ZeniteSolar/MSWI19/design/imgs_iteration_1/sw_1_var_1.jpeg

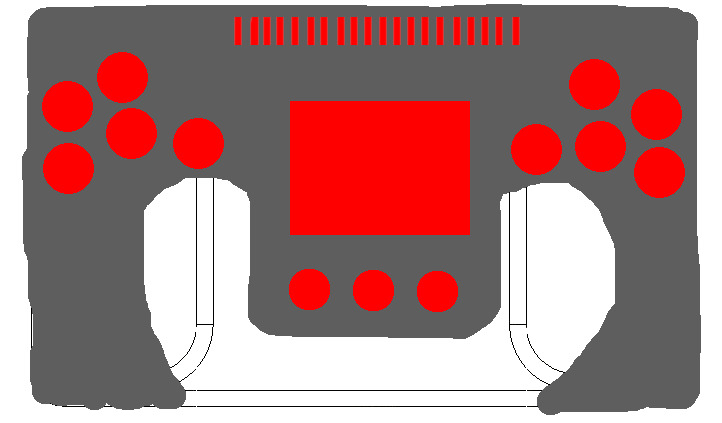
design/imgs_iteration_1/sw_1_var_1.jpeg
