ZeniteSolar/MSWI19/design/imgs_iteration_1/sw_1_var_2.jpeg

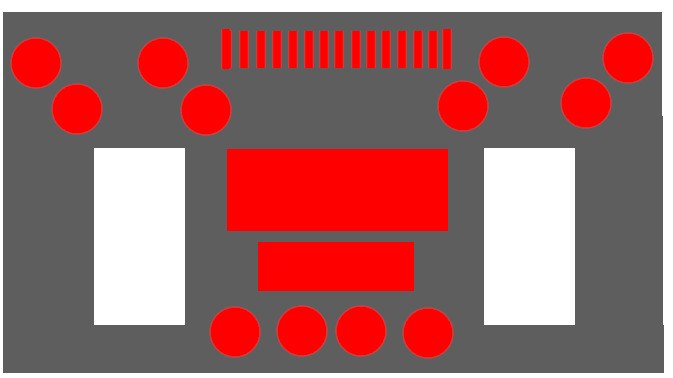
design/imgs_iteration_1/sw_1_var_2.jpeg
