ZeniteSolar/MSWI19/pcb/mswi/IMG/mswi-front.png

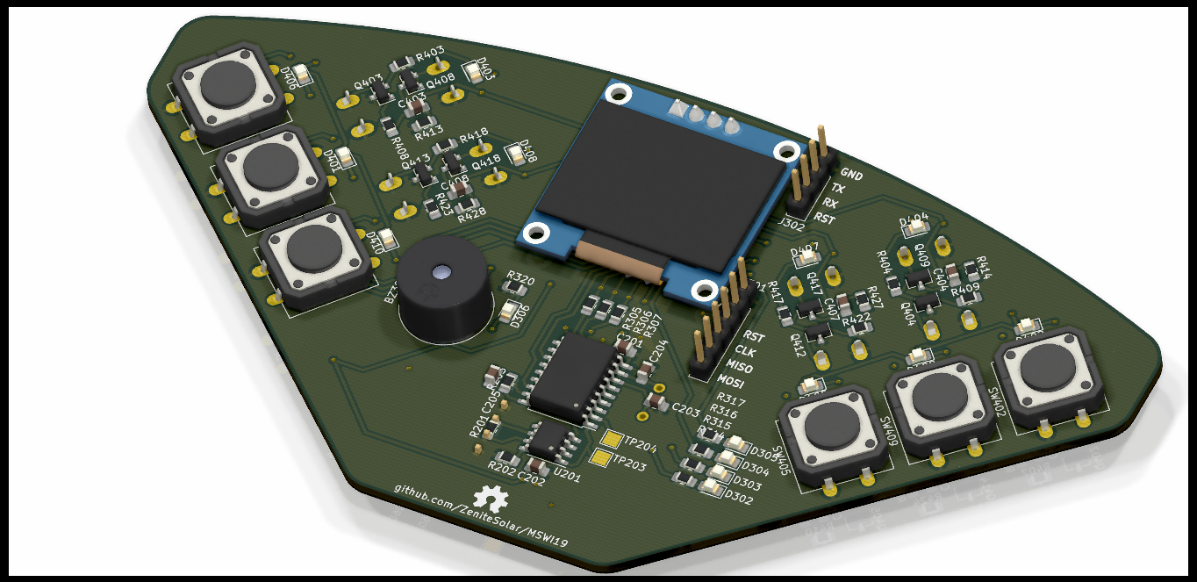
pcb/mswi/IMG/mswi-front.png
