ZeniteSolar/MSWI19/design/3D/costa_tampa.STL

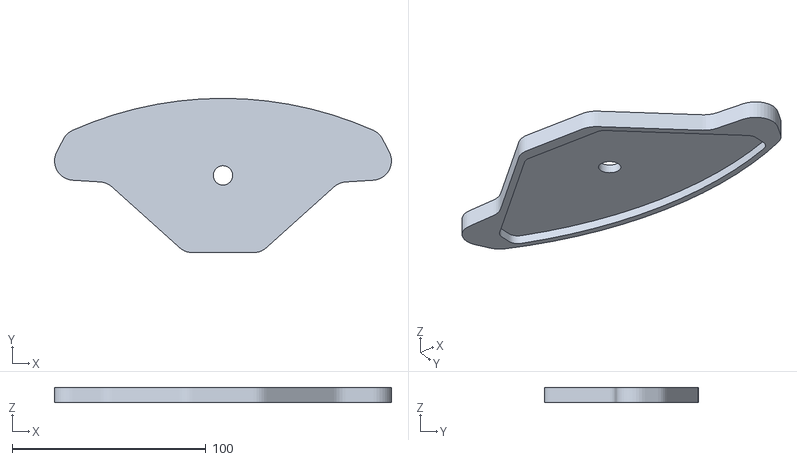
[picture p20: CAD file, 2019-12-08]
design/3D/costa_tampa.STL
174.0 x 79.7 x 8.00
