ZeniteSolar/MSWI19/design/models/display.step

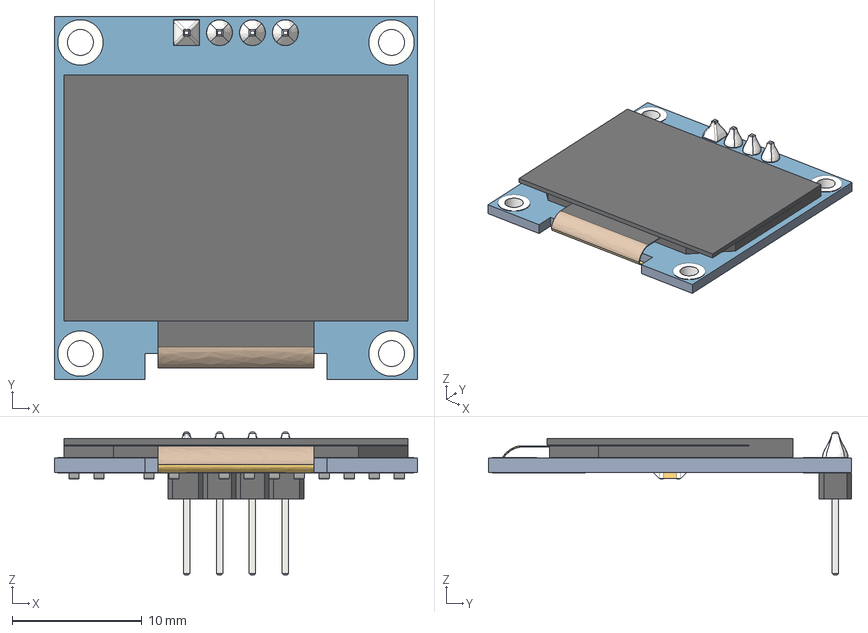
[picture p21: CAD file, 2019-10-22]
design/models/display.step
28.0 x 28.0 x 11.0 mm
