ZeniteSolar/MSWI19/design/placa_joaoa_timao.DXF

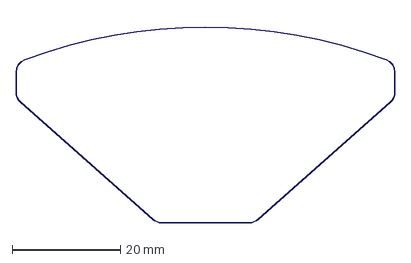
[picture p22: CAD file, 2019-08-30]
design/placa_joaoa_timao.DXF
70.0 x 38.2 mm
