ZeniteSolar/MSWI19/design/3D/CON_TIMAO_BARCO.STL

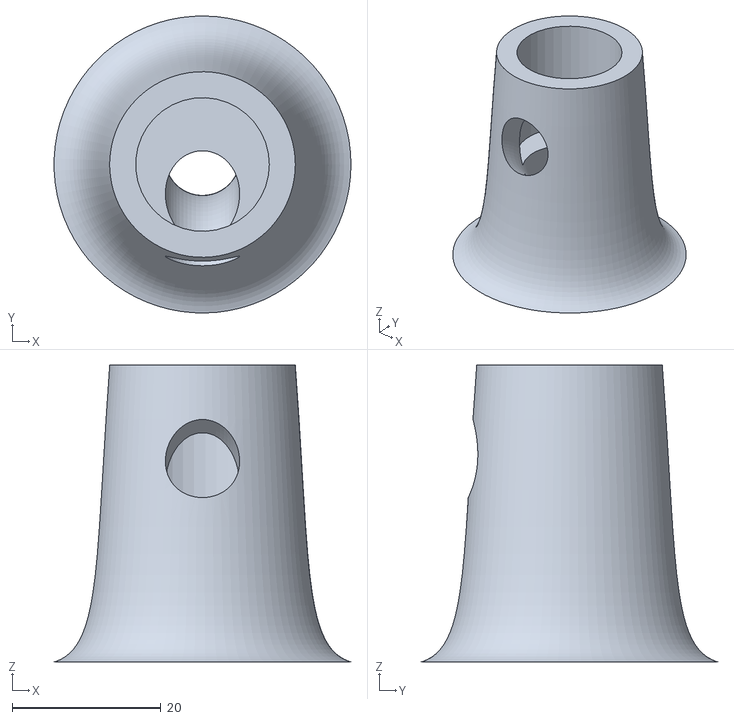
[picture p23: CAD file, 2019-12-08]
design/3D/CON_TIMAO_BARCO.STL
40.0 x 40.0 x 40.0
