ZeniteSolar/MSWI19/design/models/buzzer.step

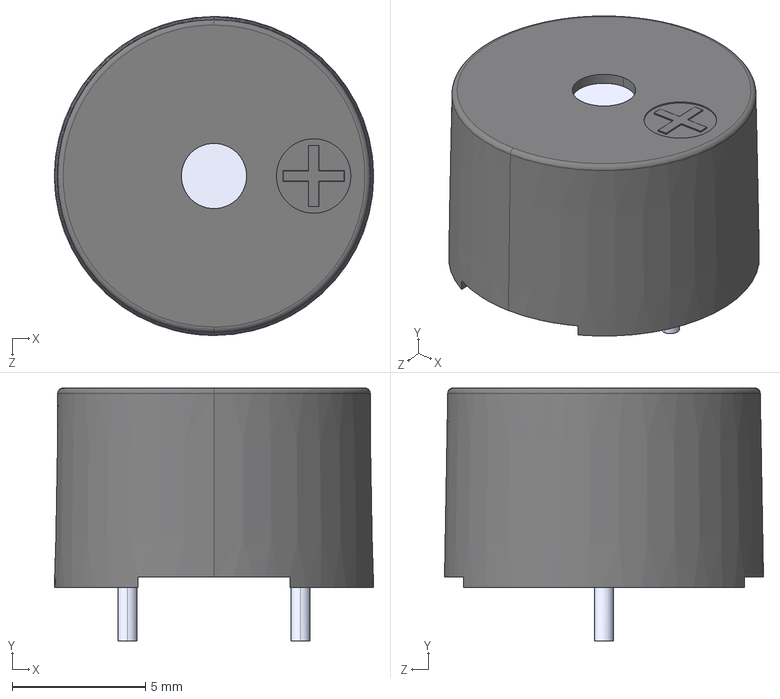
[picture p24: CAD file, 2019-10-16]
design/models/buzzer.step
12.0 x 9.50 x 12.0 mm
