ZeniteSolar/MSWI19/design/timao_joao_2_3.DXF

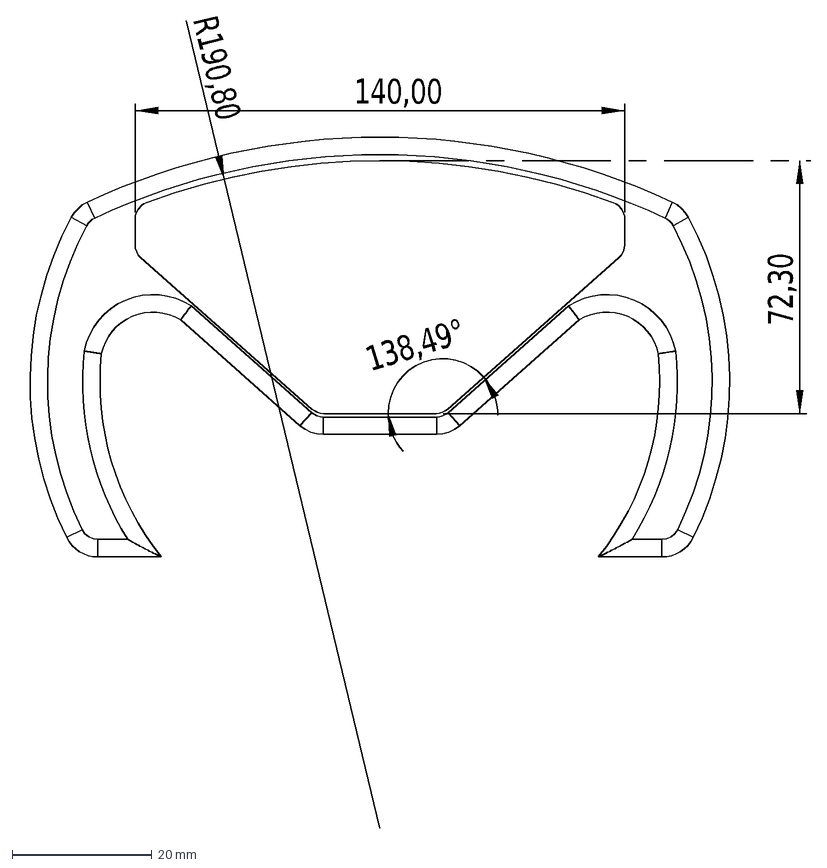
[picture p25: CAD file, 2019-08-30]
design/timao_joao_2_3.DXF
72,30
140,00
R190,80
138,49°
