ZeniteSolar/MSWI19/design/3D/timao_joao_V_2.STL

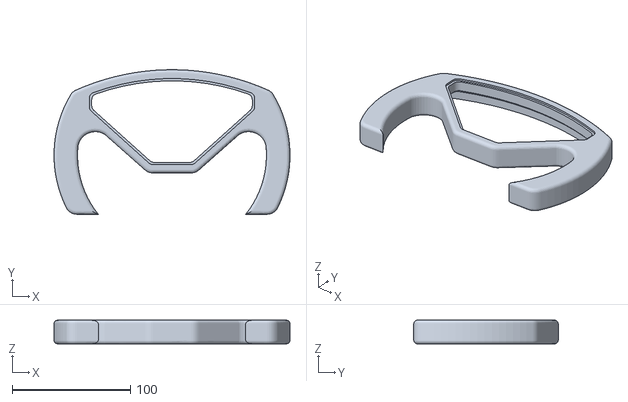
[picture p26: CAD file, 2019-12-08]
design/3D/timao_joao_V_2.STL
199.9 x 122.5 x 20.0
