ZeniteSolar/MSWI19/design/models/switch.FCStd

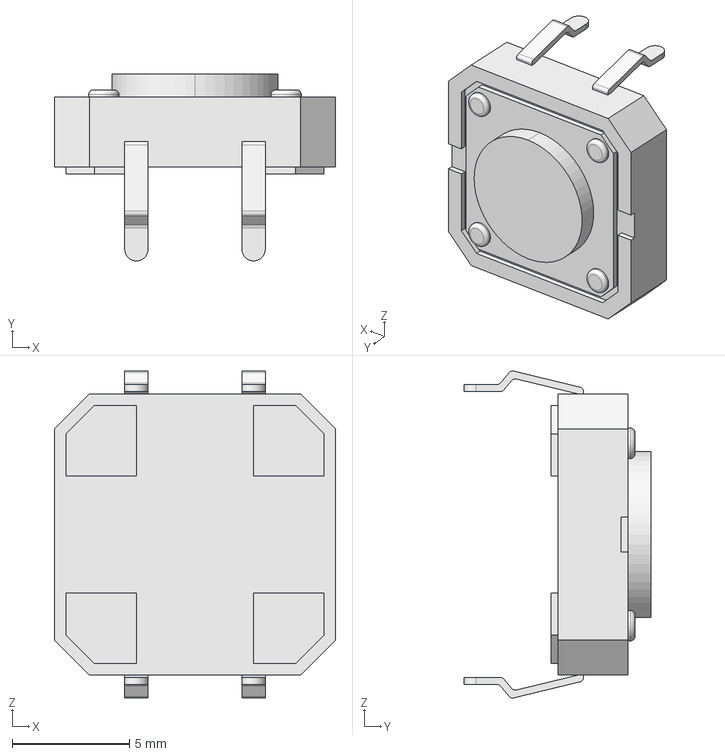
[picture p27: CAD file, 2019-10-16]
design/models/switch.FCStd
12.0 x 7.97 x 14.0 mm
