ZeniteSolar/MSWI19/pcb/mswi/PDF/mswi-Eco2_User.pdf

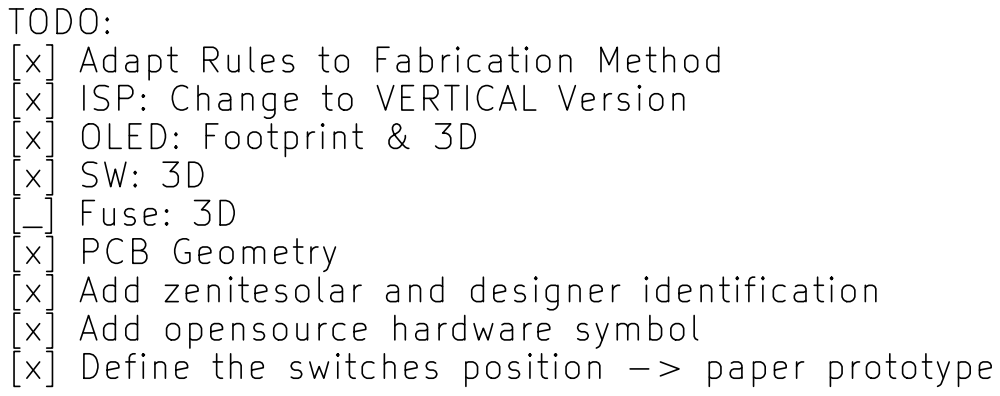
[picture p28: page 1]

TODO:
[x] Adapt Rules to Fabrication Method
[x] ISP: Change to VERTICAL Version
[x] OLED: Footprint & 3D
[_] Fuse: 3D
[x] PCB Geometry
[x] Add zenitesolar and designer identification
[x] Add opensource hardware symbol
[x] Define the switches position -> paper prototype
