ZeniteSolar/MSWI19/pcb/mswi/PDF/mswi.pdf

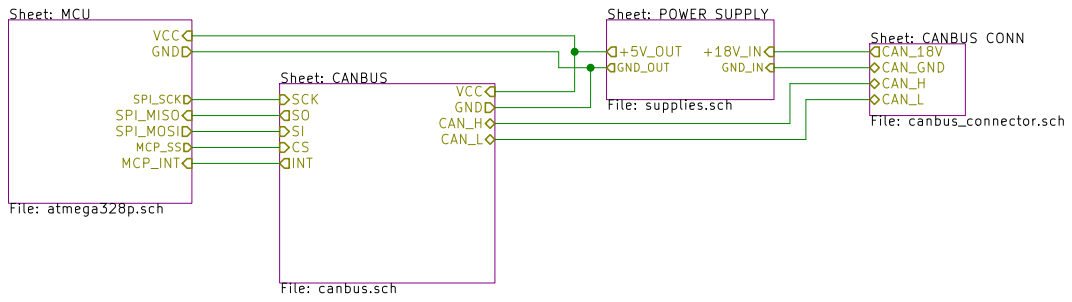
[picture p29: page 1]

Id: 1/6 Title: File: mswi.sch Sheet: /

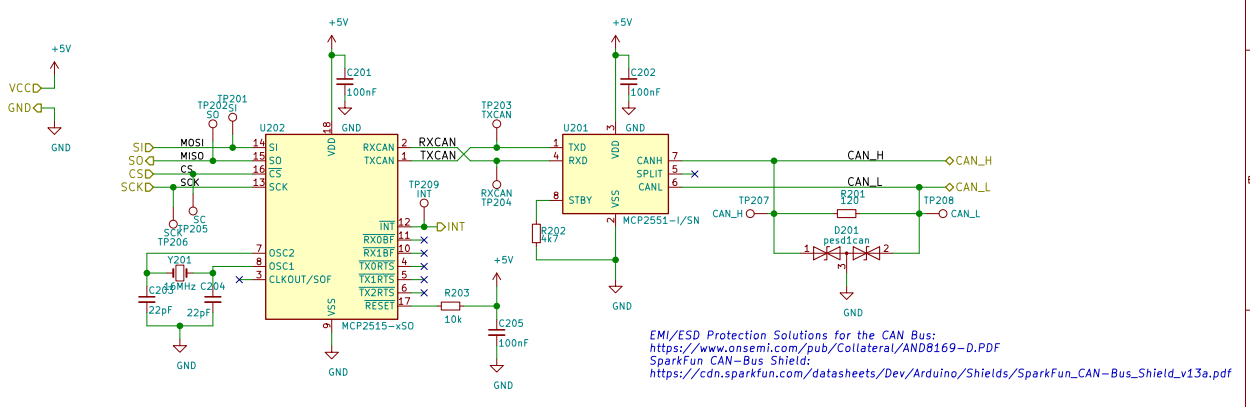
[picture p30: page 2]

3 RXD 4 SPLIT 5 CANL 6 CANH 7 STBY 8 U201 MCP2551-I/SN SI

EMI/ESD Protection Solutions for the CAN Bus:
https://www.onsemi.com/pub/Collateral/AND8169-D.PDF
SparkFun CAN-Bus Shield:
https://cdn.sparkfun.com/datasheets/Dev/Arduino/Shields/SparkFun_CAN-Bus_Shield_v13a.pdf

Id: 2/6 Title: File: canbus.sch Sheet: /CANBUS/

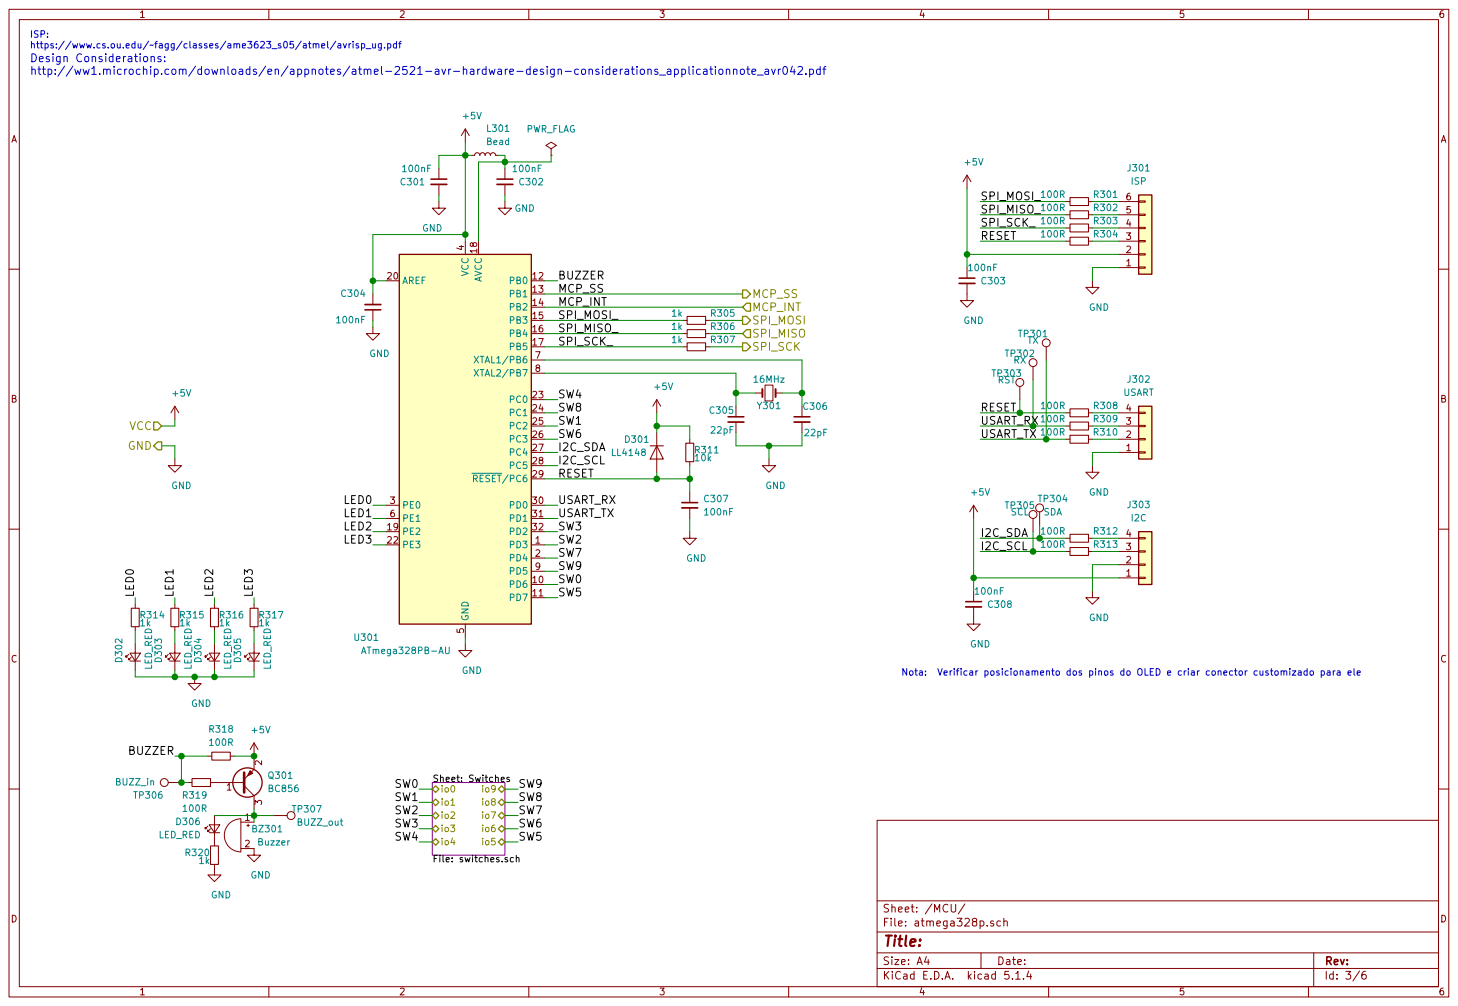
[picture p31: page 3]

ISP: https://www.cs.ou.edu/fagg/classes/ame3623_s05/atmel/avrisp_ug.pdf
Design Considerations:
http://ww1.microchip.com/downloads/en/appnotes/atmel-2521-avr-hardware-design-considerations_applicationnote_avr042.pdf

100R R302
100R R303
100R R304

2 3 Q301 BC856 PD3 1 PD6 10 PD7 11 PB0 12 PB1 13 PB2 14 PB3 15 PB4 16 PB5 17 AVCC 18 PE2 19 PD4 2 AREF 20 PE3 22 PC0 23 PC1 24 PC2 25 PC3 26 PC4 27 PC5 28 RESET/PC6 29 PE0 3 PD0 30 PD1 31 PD2 32 VCC

Nota: Verificar posicionamento dos pinos do OLED e criar conector customizado para ele

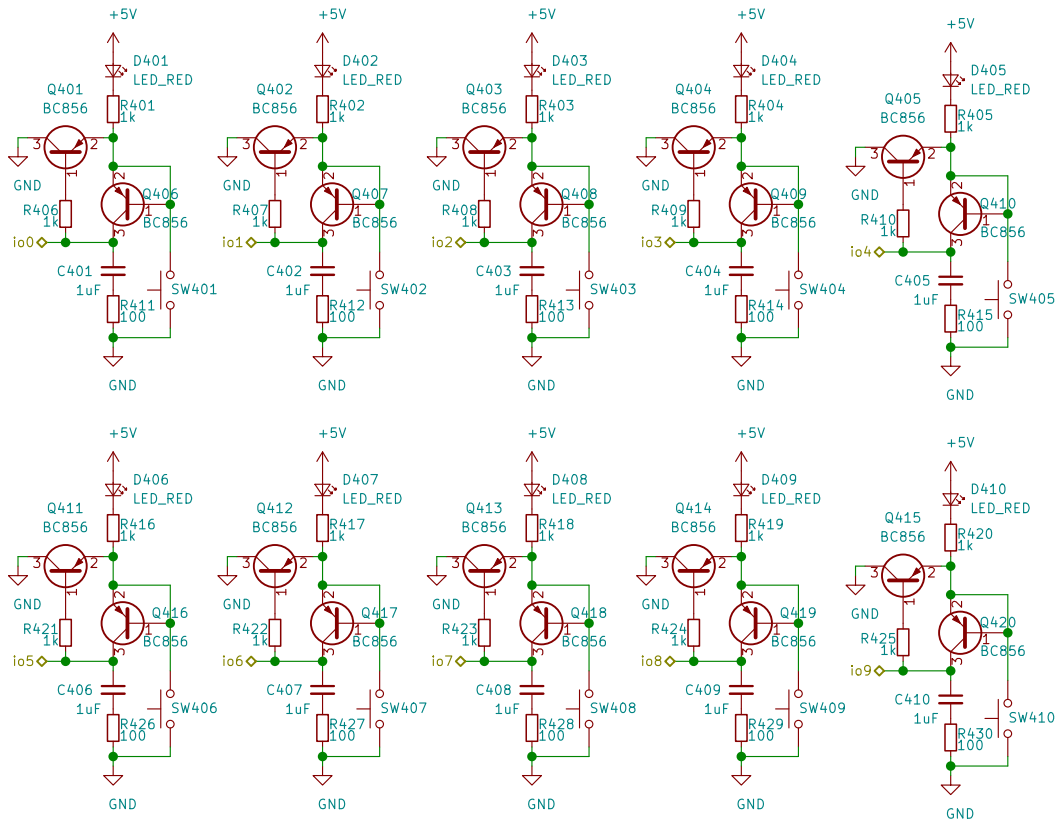
[picture p32: page 4]

Id: 4/6 Title: File: switches.sch Sheet: /MCU/Switches/ R423

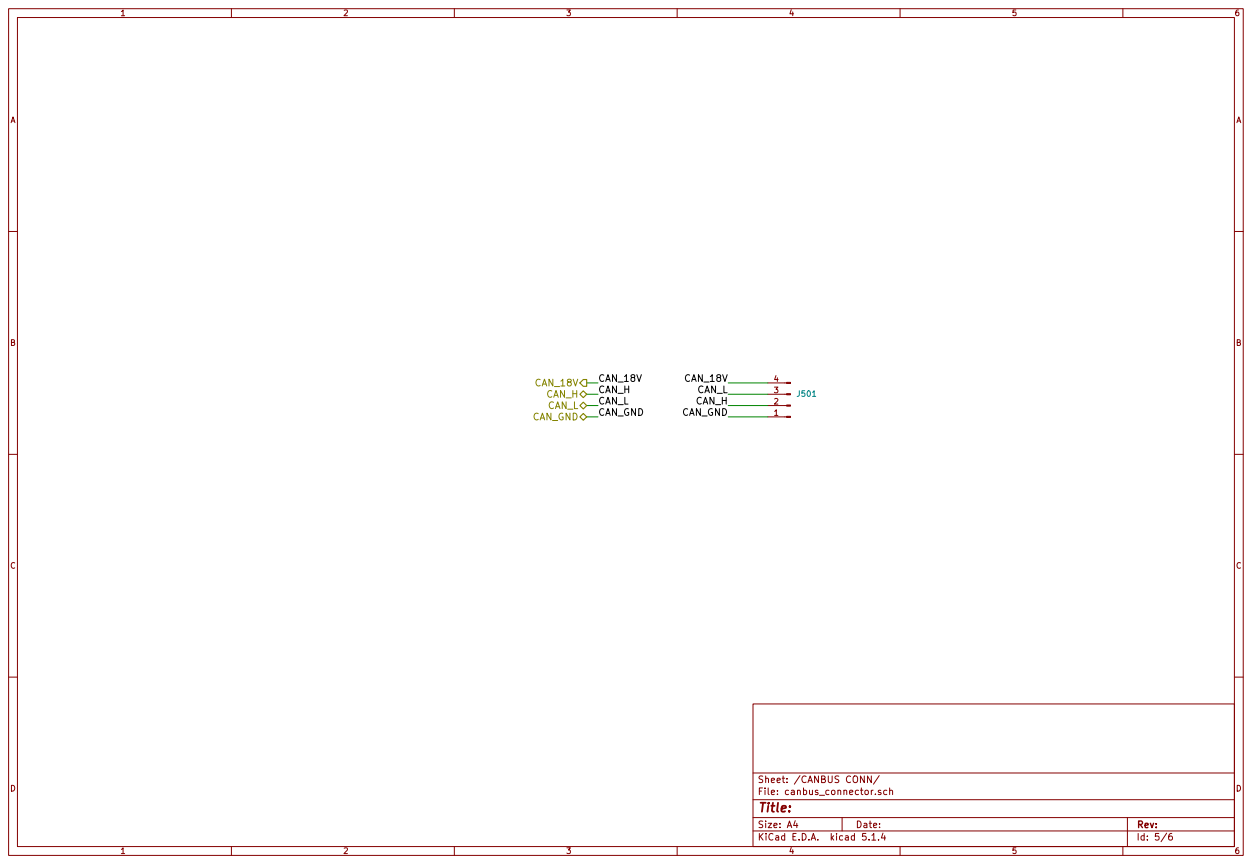
[picture p33: page 5]

File: canbus_connector.sch Sheet: /CANBUS CONN/
Id: 5/6 Title:

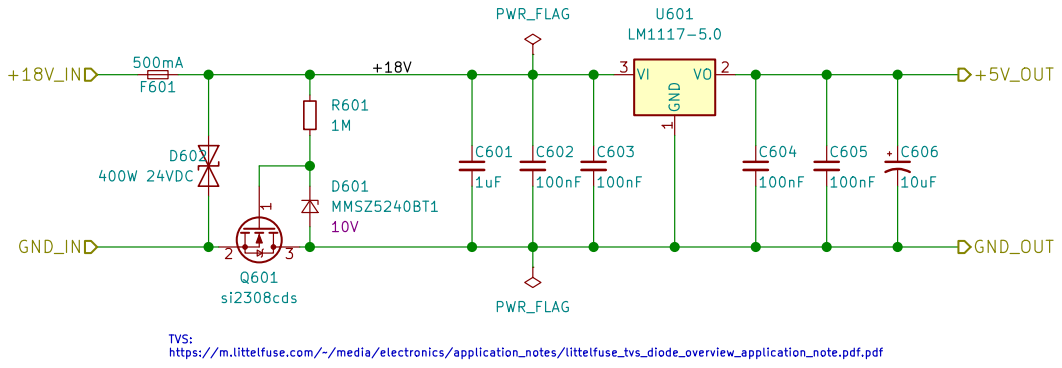
[picture p34: page 6]

File: supplies.sch Sheet: /POWER SUPPLY/ PWR_FLAG

TVS: https://m.littelfuse.com//media/electronics/application_notes/littelfuse_tvs_diode_overview_application_note.pdf.pdf
