ZeniteSolar/MSWI19/pcb/mswi/PDF/mswi-B_CrtYd.pdf

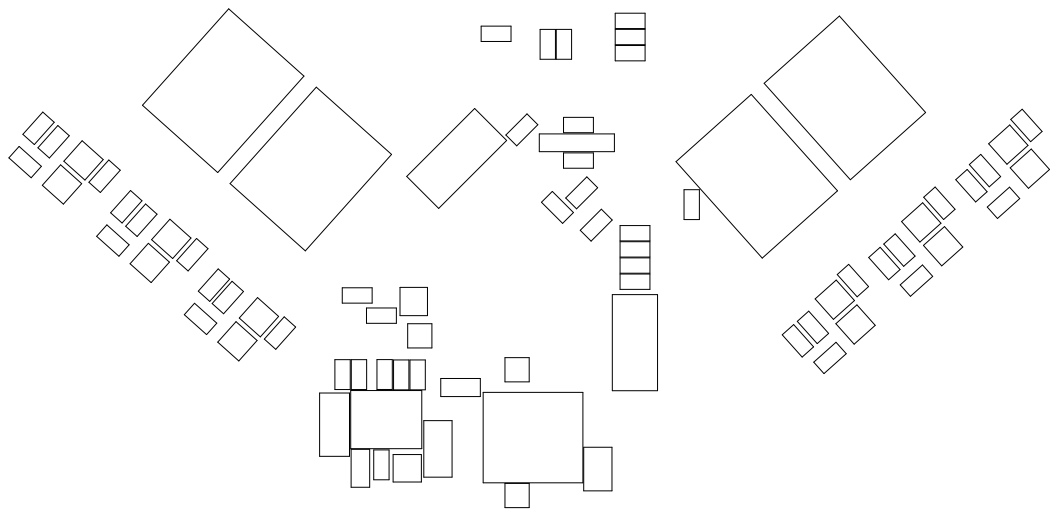
[picture p35: page 1]
