ZeniteSolar/MSWI19/pcb/mswi/PDF/mswi-B_Cu.pdf

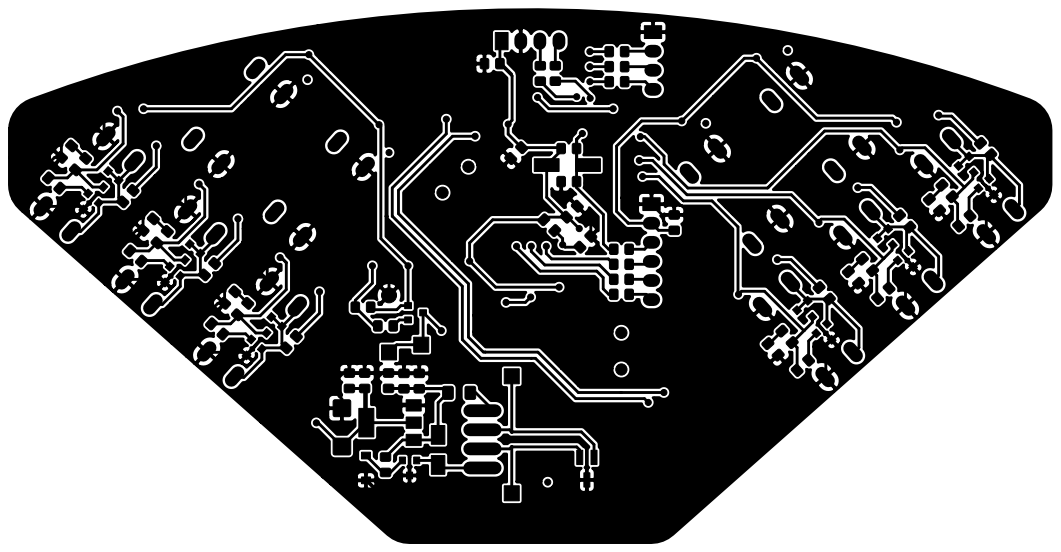
[picture p36: page 1]
