ZeniteSolar/MSWI19/pcb/mswi/PDF/mswi-B_Fab.pdf

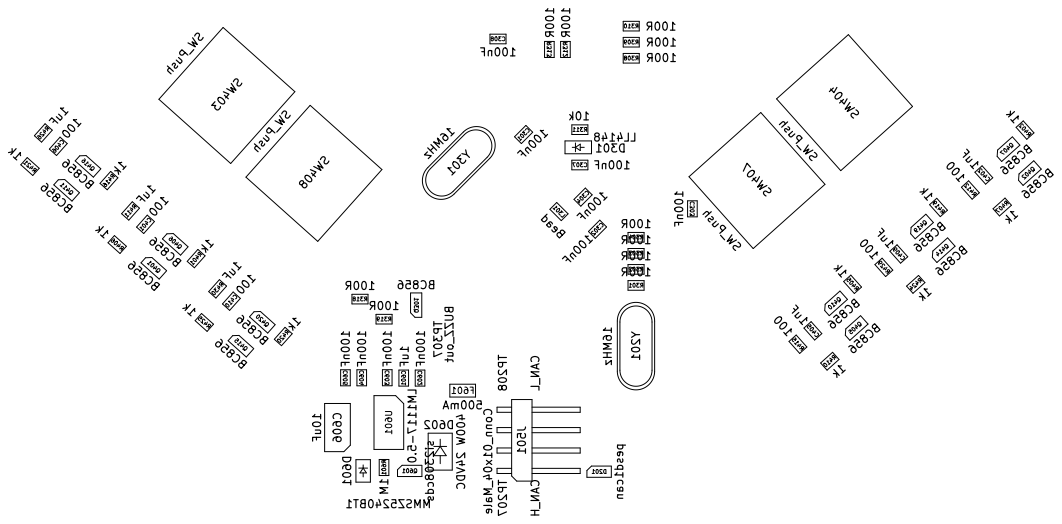
[picture p37: page 1]
