ZeniteSolar/MSWI19/pcb/mswi/PDF/mswi-B_Mask.pdf

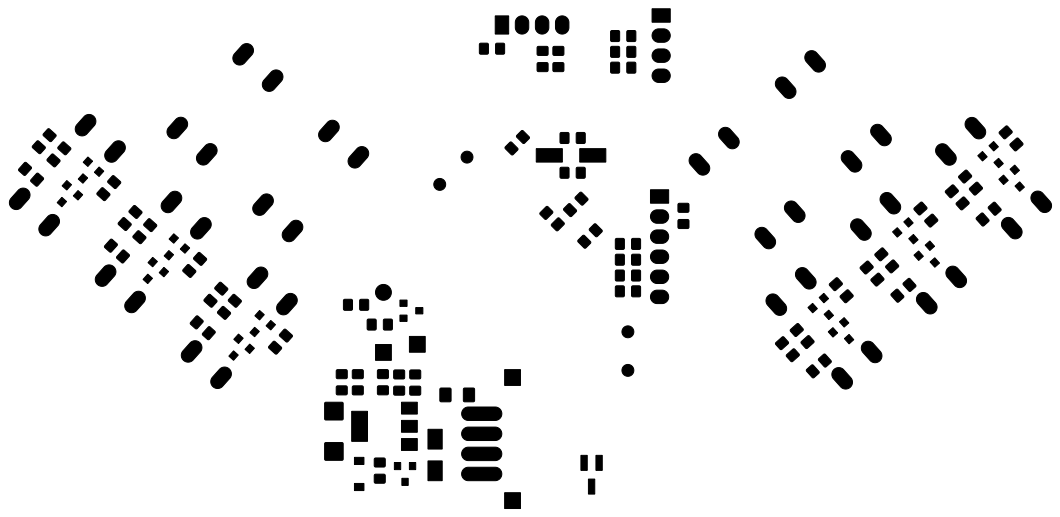
[picture p38: page 1]
