ZeniteSolar/MSWI19/pcb/mswi/PDF/mswi-B_Paste.pdf

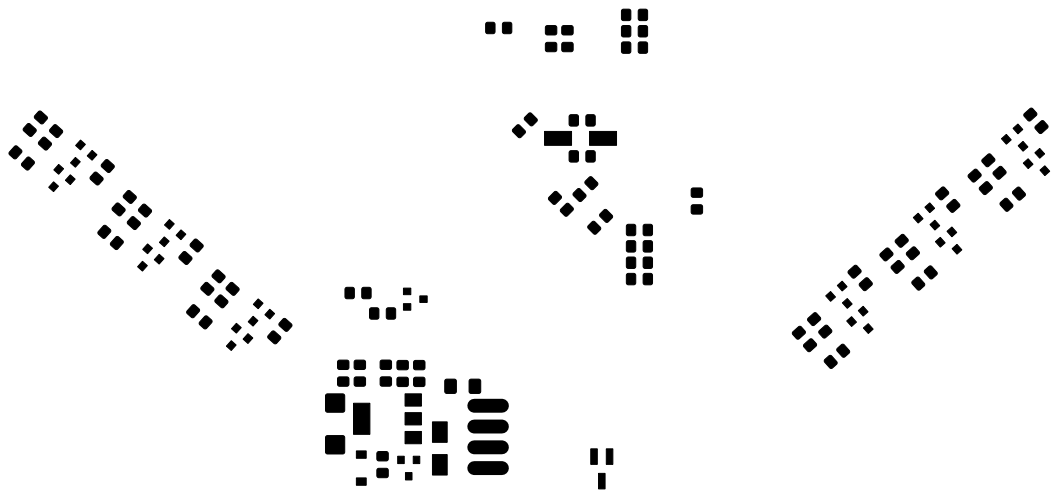
[picture p39: page 1]
