ZeniteSolar/MSWI19/pcb/mswi/PDF/mswi-B_SilkS.pdf

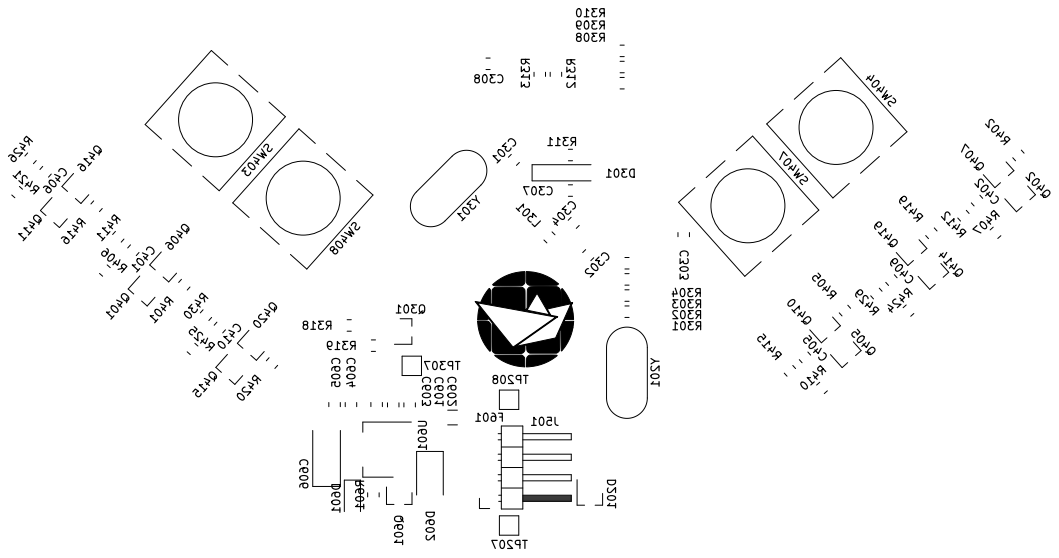
[picture p40: page 1]
