ZeniteSolar/MSWI19/pcb/mswi/PDF/mswi-Dwgs_User.pdf

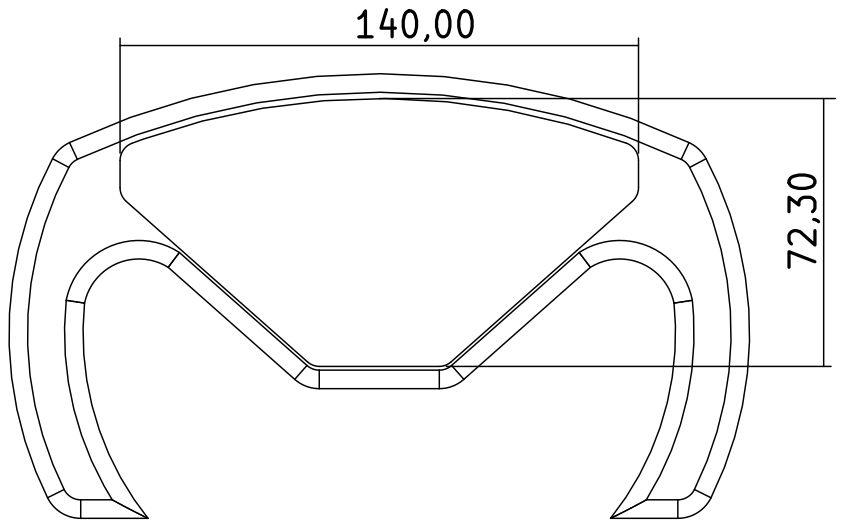
[picture p41: page 1]
