ZeniteSolar/MSWI19/pcb/mswi/PDF/mswi-Edge_Cuts.pdf

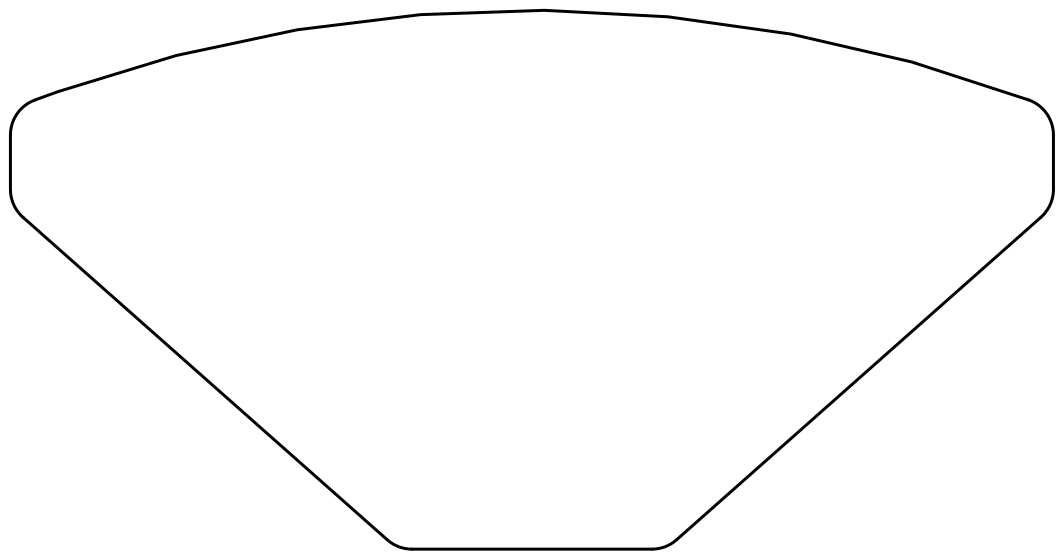
[picture p42: page 1]
