ZeniteSolar/MSWI19/pcb/mswi/PDF/mswi-F_CrtYd.pdf

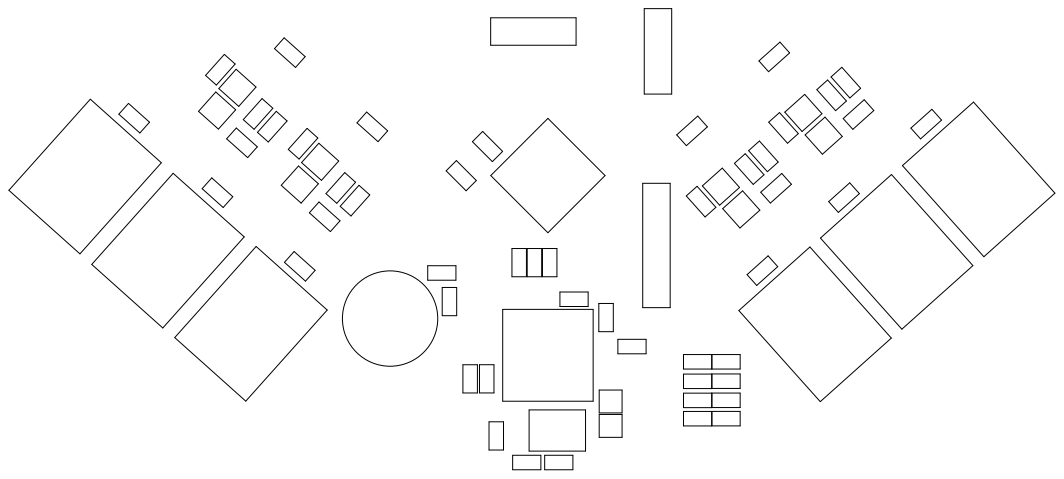
[picture p43: page 1]
