ZeniteSolar/MSWI19/pcb/mswi/PDF/mswi-F_Cu.pdf

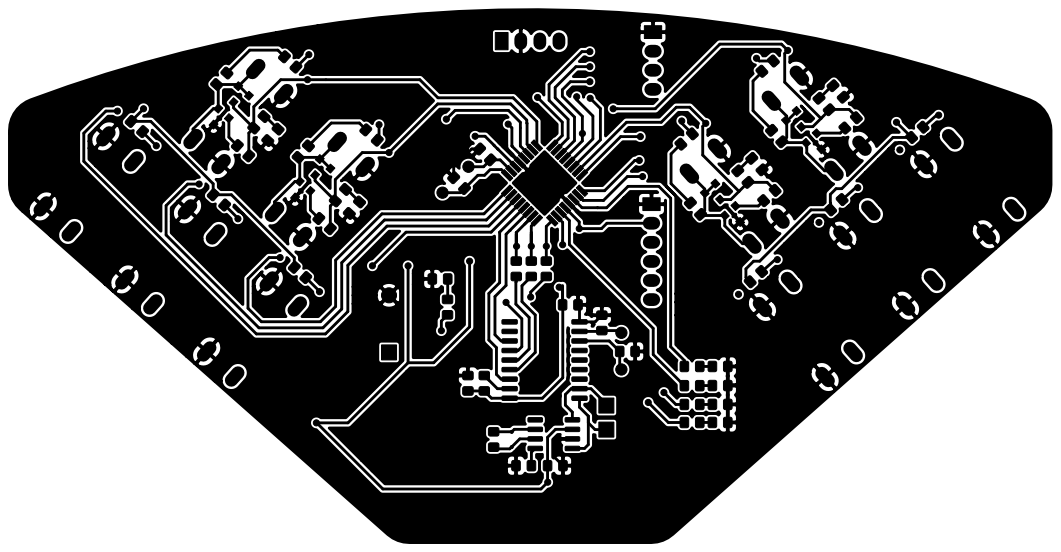
[picture p44: page 1]
