ZeniteSolar/MSWI19/pcb/mswi/PDF/mswi-F_Fab.pdf

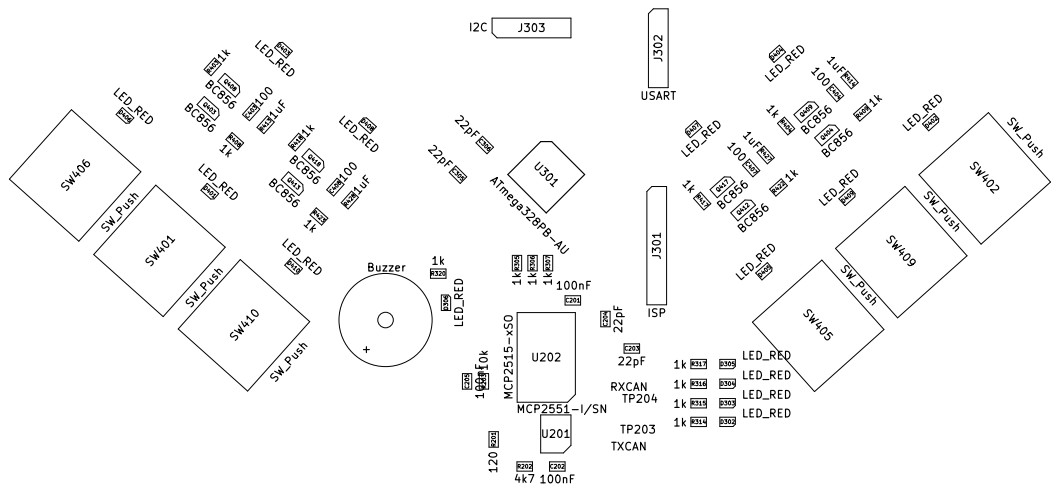
[picture p45: page 1]
