ZeniteSolar/MSWI19/pcb/mswi/PDF/mswi-F_Mask.pdf

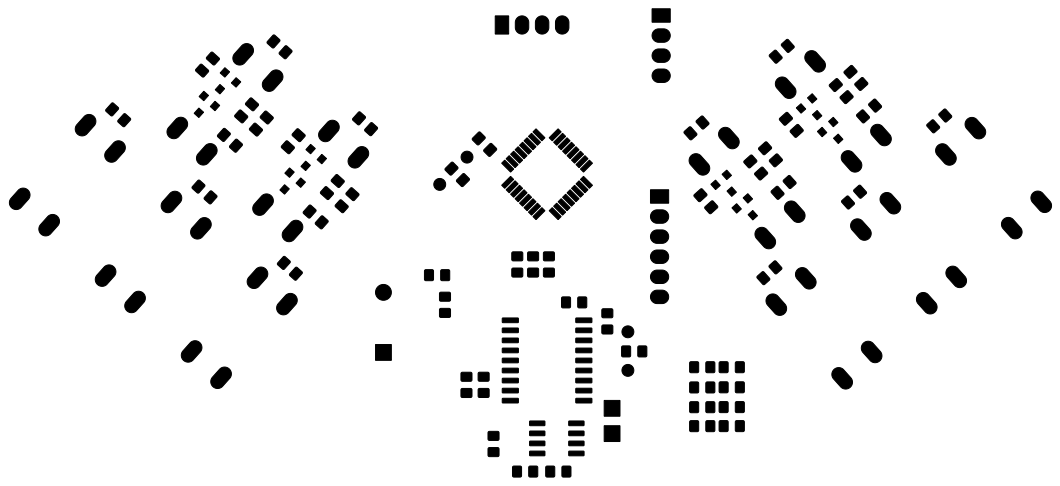
[picture p46: page 1]
