ZeniteSolar/MSWI19/pcb/mswi/PDF/mswi-F_Paste.pdf

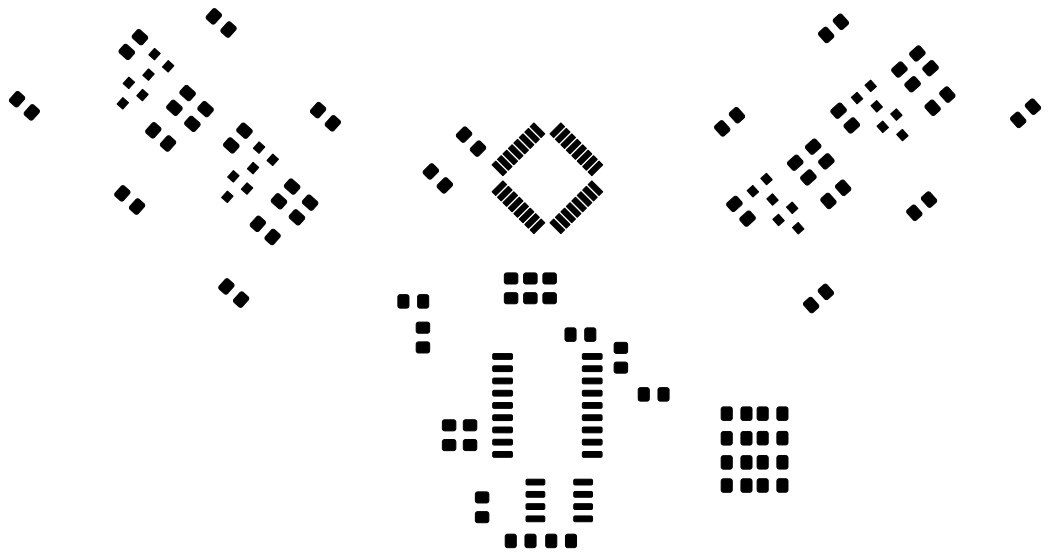
[picture p47: page 1]
