ZeniteSolar/MSWI19/pcb/mswi/PDF/mswi-F_SilkS.pdf

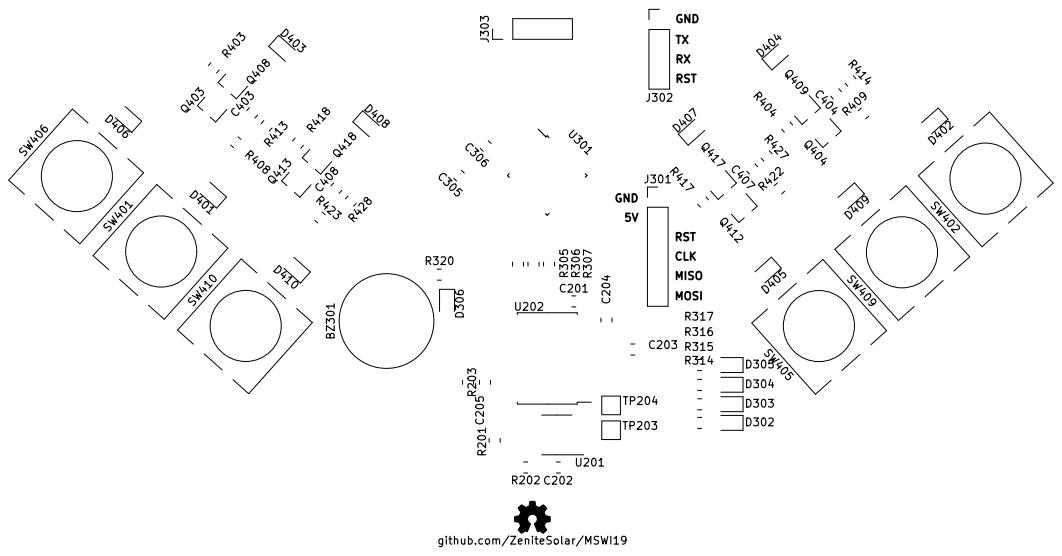
[picture p48: page 1]
