ZeniteSolar/MSWI19/simulations/input_alt.asc

atmega: res; {Ro}
buzzer: res; 1650
C1: cap; 100n
C2: cap; 1u
C3: cap; 100n
C4: cap; 100n
C5: cap; 100n
C6: cap; 10u
C7: polcap; 10u
D1: zener; MMBZ10VAL
D2: zener; BZX384B5V6
F: res; .150
leds: res; 650
M1: nmos; IPP024N06N3
Oled: res; 165
Q2: pnp; BC856A
R1: res-; 1u
R2: res-; 1u
R3: res; 1Meg
R4: res; 1k
R6: res-; 1u
V1: voltage-; {Vin}
Named nets: 0, Vin+, g, d, s, +5V, Vin-, +18V
.tran 0 1 0 startup
.param Vin = 18
.param Vo = 5
.param Io = 10e-3
.param Ro = Vo/Io
500mA FUSE
10~15V
480nW
70uW
80uW
460uW
750mW
Po = 250mW
Pin = 1W
Eff = 25%
Polarity Protection Losses = 500uW
