ZeniteSolar/MSWI19/simulations/buzzer.asc

BUZZ: res; {R_BUZZ}
Q1: pnp; BC856A
R1: res; 100
R2: res; 10k
signal: voltage-; PULSE(0 5 1 1n 1n 1 2 2)
VCC: voltage; 5
Named nets: +5V, 0, in, out
.param I_BUZZ = 30e-3
.param VCC = 5
.param R_BUZZ = VCC/I_BUZZ
.tran 0 5 0 startup
150mw
30mw
Pin=88.577mW
Pout=86.587mW
Eff=97.78%
