ZeniteSolar/MSWI19/simulations/switches_and_leds.asc

C1: cap; 1u; V=25 Irms=3.55 Rser=0.0172 Lser=0 mfg="KEMET" pn="C1210C105K3PAC" type="X5R"
D1: diode
LD1: LED; SFH4240
Q1: pnp; BC856A
Q2: pnp; BC856A
R1: res; 470
R2: res; 100
R3: res; 100
R4: res; 100
R5: res; 100
R6: res; 100
S1: sw; IDEAL_SW
turn_off_bounce: voltage-; PULSE(0 10 2 1n 1n 1m 2m 10)
turn_on_bounce: voltage-; PULSE(10 0 1 1n 1n 1m 2m 10)
U1: LM358_NS
uC-pull-up: res; 20k
V1: voltage-; PULSE(5 0 3 1n 1n 1 0 1)
V2: voltage-; PULSE(0 5 1 1n 1n 1 0 1)
VCC: voltage; {VCC}
VIH: voltage; {0.7*VCC}
VIL: voltage; {0.3*VCC}
Named nets: sw_debounced, 0, +5V, on-off, sw_ctrl, sw_bounced, VIH, VIL, led_ctrl
.model IDEAL_SW SW(Ron=1u Roff=1Meg Vt=0, Vh=0, Lser=0, Vser=0)
.tran 0 5 0 startup
.param VCC=5
