ZeniteSolar/MSWI19/pcb/mswi/mswi.kicad_pcb

## KiCad design pcb/mswi/mswi.kicad_pcb (2019-10-24)

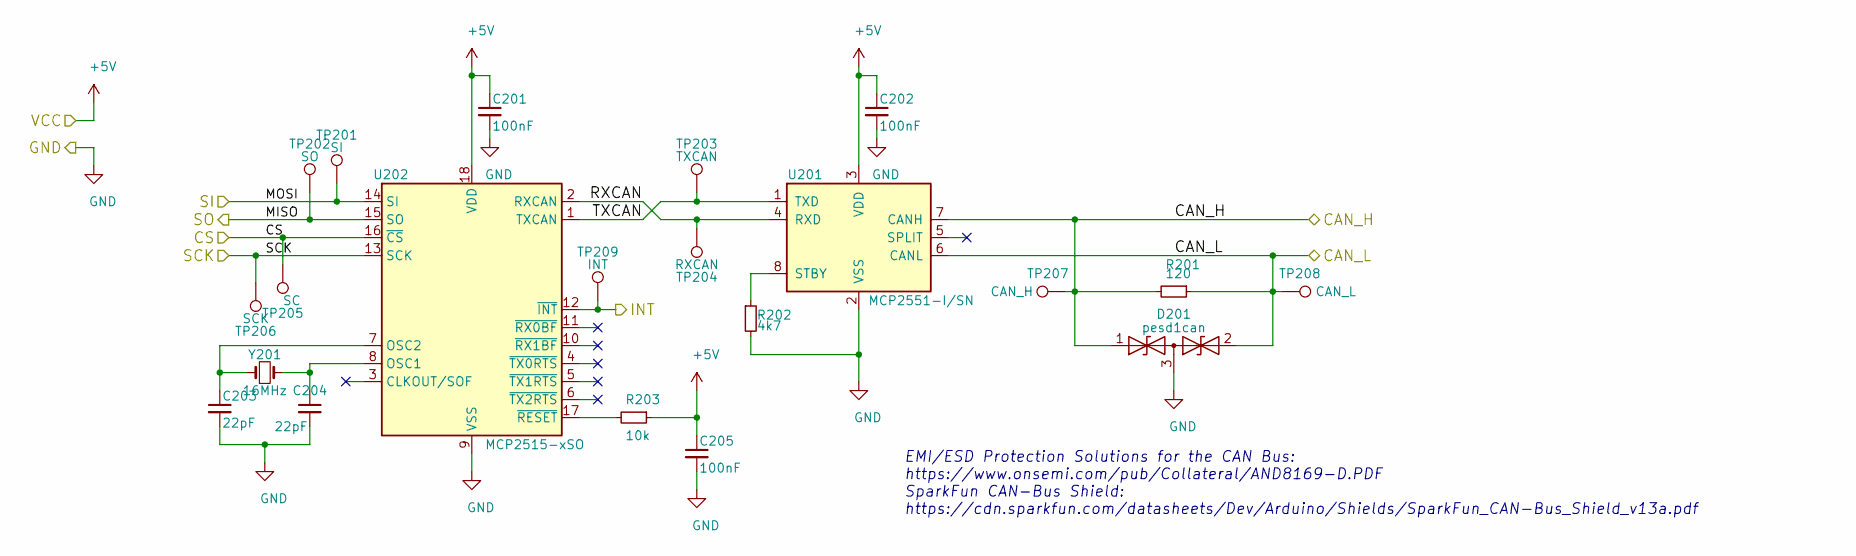
[picture p49: schematic canbus.sch]

Parts:
C201, C202, C205: 100nF; C_0805_2012Metric_Pad1.15x1.40mm_HandSolder
C203, C204: 22pF; C_0805_2012Metric_Pad1.15x1.40mm_HandSolder
D201: pesd1can; SOT-23_Handsoldering
R201: 120; R_0805_2012Metric_Pad1.15x1.40mm_HandSolder
R202: 4k7; R_0805_2012Metric_Pad1.15x1.40mm_HandSolder
R203: 10k; R_0805_2012Metric_Pad1.15x1.40mm_HandSolder
TP201: SI; TestPoint_Pad_2.0x2.0mm
TP202: SO; TestPoint_Pad_2.0x2.0mm
TP203: TXCAN; TestPoint_Pad_2.0x2.0mm
TP204: RXCAN; TestPoint_Pad_2.0x2.0mm
TP205: SC; TestPoint_Pad_2.0x2.0mm
TP206: SCK; TestPoint_Pad_2.0x2.0mm
TP207: CAN_H; TestPoint_Pad_2.0x2.0mm
TP208: CAN_L; TestPoint_Pad_2.0x2.0mm
TP209: INT; TestPoint_Pad_2.0x2.0mm
U201: MCP2551-I/SN; SOIC-8_3.9x4.9mm_P1.27mm
U202: MCP2515-xSO; SOIC-18W_7.5x11.6mm_P1.27mm
Y201: 16MHz; Crystal_HC49-U_Vertical

Connections:
+5V: C201.1, C202.1, C205.1, R203.1, U201.3 (VDD), U202.18 (VDD); also elsewhere on the board
/CANBUS CONN/CAN_H: D201.1 (A1), R201.2, TP207.1, U201.7 (CANH); also elsewhere on the board
/CANBUS CONN/CAN_L: D201.2 (A2), R201.1, TP208.1, U201.6 (CANL); also elsewhere on the board
/CANBUS/CS: TP205.1, U202.16 (~CS); also elsewhere on the board
/CANBUS/INT: TP209.1, U202.12 (~INT); also elsewhere on the board
/CANBUS/RXCAN: TP204.1, U201.4 (RXD), U202.2 (RXCAN)
/CANBUS/SCK: TP206.1, U202.13 (SCK); also elsewhere on the board
/CANBUS/SI: TP201.1, U202.14 (SI); also elsewhere on the board
/CANBUS/SO: TP202.1, U202.15 (SO); also elsewhere on the board
/CANBUS/TXCAN: TP203.1, U201.1 (TXD), U202.1 (TXCAN)
GND: C201.2, C202.2, C203.2, C204.2, C205.2, D201.3 (common), R202.2, U201.2 (VSS), U202.9 (VSS); also elsewhere on the board
unnamed: C203.1, U202.7 (OSC2), Y201.1
unnamed: C204.1, U202.8 (OSC1), Y201.2
unnamed: R202.1, U201.8 (STBY)
unnamed: R203.2, U202.17 (~RESET)

Notes on the sheet:
EMI/ESD Protection Solutions for the CAN Bus: https://www.onsemi.com/pub/Collateral/AND8169-D.PDF SparkFun CAN-Bus Shield: https://cdn.sparkfun.com/datasheets/Dev/Arduino/Shields/SparkFun_CAN-Bus_Shield_v13a.pdf

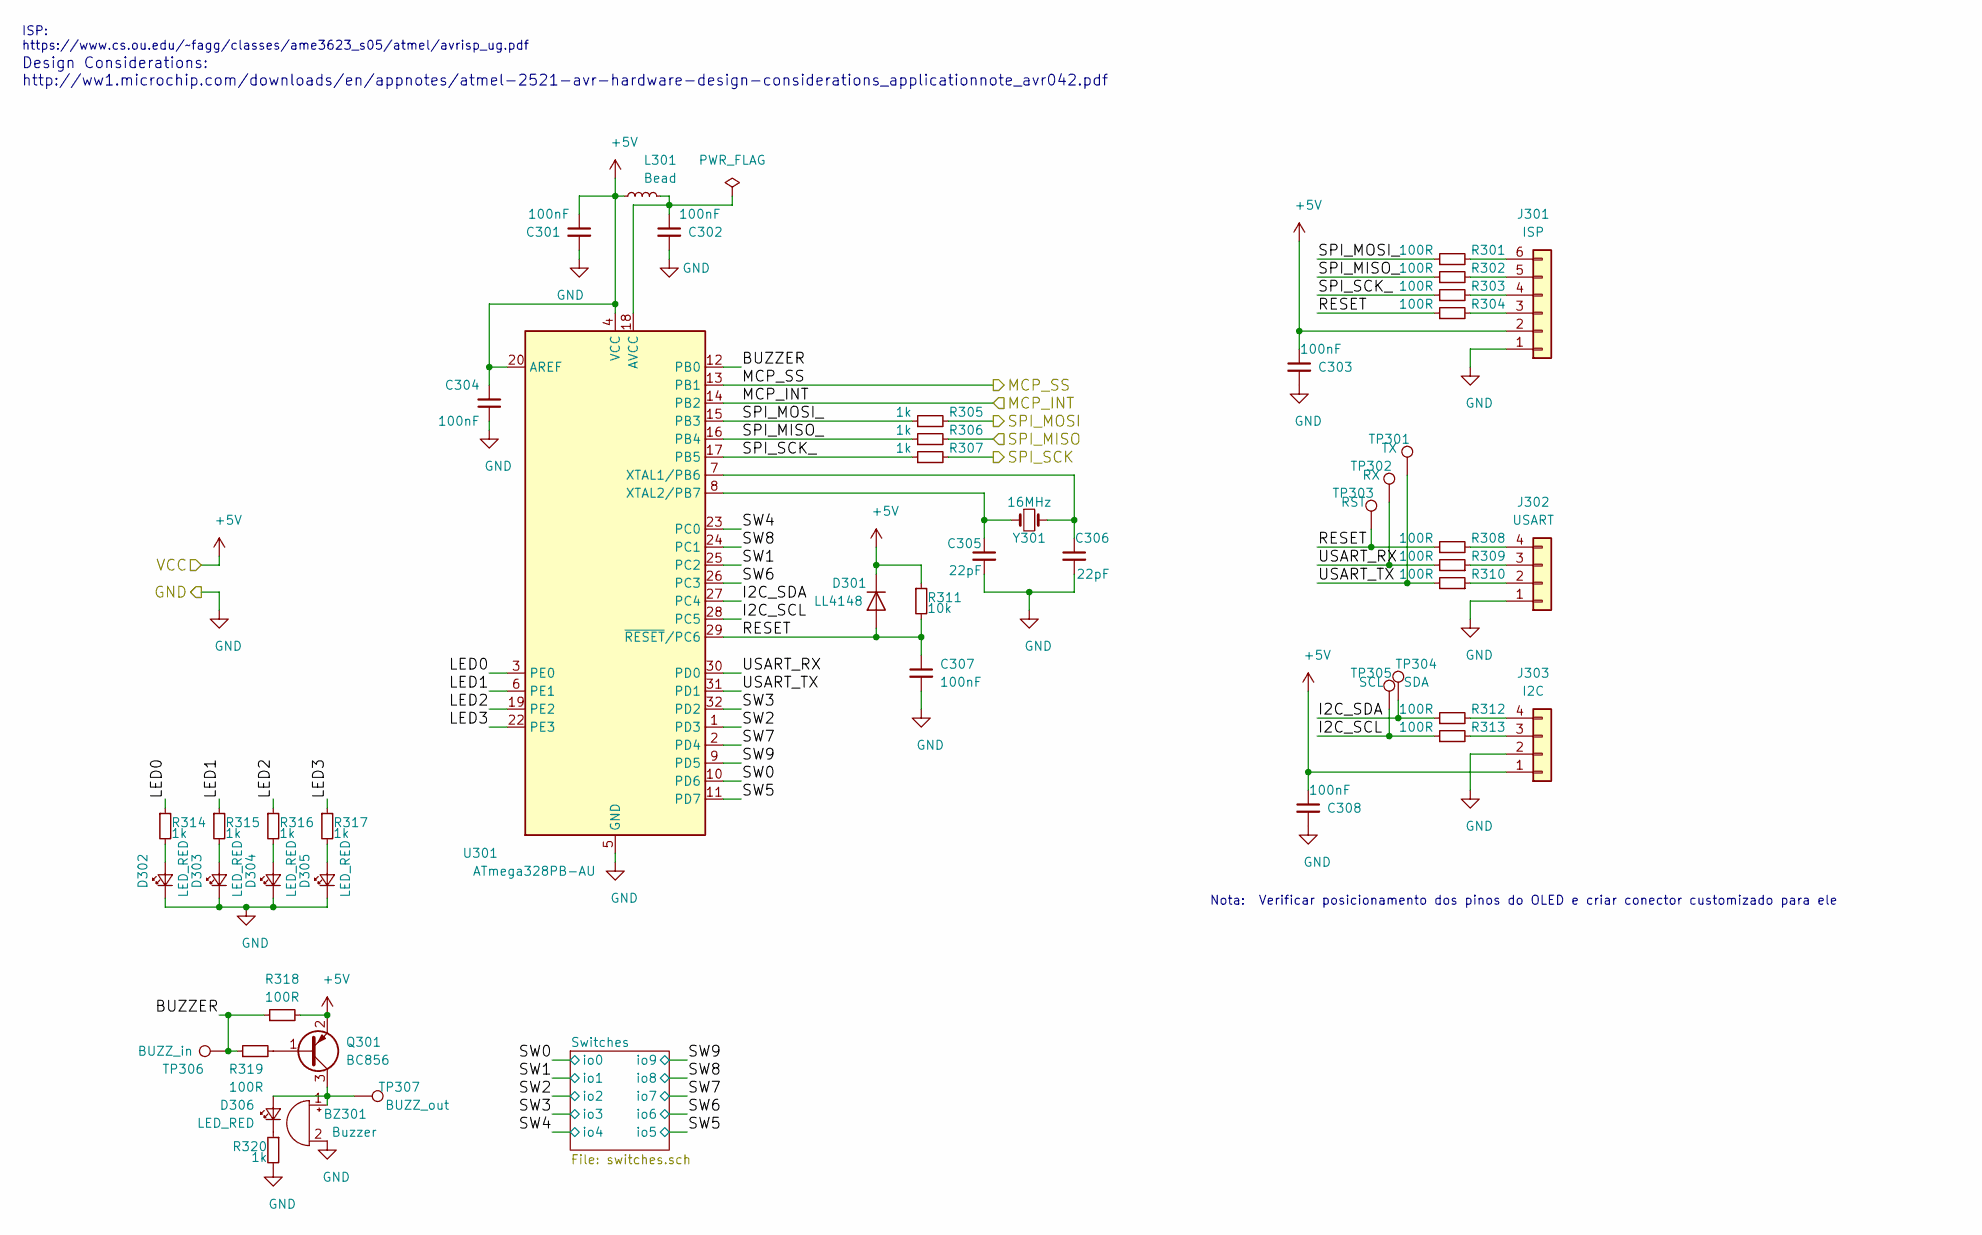
[picture p50: schematic atmega328p.sch]

Parts:
BZ301: Buzzer; Buzzer_12x9.5RM7.6
C301, C302, C303, C304, C307, C308: 100nF; C_0805_2012Metric_Pad1.15x1.40mm_HandSolder
C305, C306: 22pF; C_0805_2012Metric_Pad1.15x1.40mm_HandSolder
D301: LL4148; D_MiniMELF_Handsoldering
D302, D303, D304, D305, D306: LED_RED; LED_0805_2012Metric_Pad1.15x1.40mm_HandSolder
J301: ISP; PinHeader_1x06_P2.54mm_Vertical
J302: USART; PinHeader_1x04_P2.54mm_Vertical
J303: I2C; PinHeader_1x04_P2.54mm_Vertical
L301: Bead; L_0805_2012Metric_Pad1.15x1.40mm_HandSolder
Q301: BC856; SOT-23
R301, R302, R303, R304, R308, R309, R310, R312, R313, R318, R319: 100R; R_0805_2012Metric_Pad1.15x1.40mm_HandSolder
R305, R306, R307, R314, R315, R316, R317, R320: 1k; R_0805_2012Metric_Pad1.15x1.40mm_HandSolder
R311: 10k; R_0805_2012Metric_Pad1.15x1.40mm_HandSolder
TP301: TX; TestPoint_Pad_2.0x2.0mm
TP302: RX; TestPoint_Pad_2.0x2.0mm
TP303: RST; TestPoint_Pad_2.0x2.0mm
TP304: SDA; TestPoint_Pad_2.0x2.0mm
TP305: SCL; TestPoint_Pad_2.0x2.0mm
TP306: BUZZ_in; TestPoint_Pad_2.0x2.0mm
TP307: BUZZ_out; TestPoint_Pad_2.0x2.0mm
U301: ATmega328PB-AU; TQFP-32_7x7mm_P0.8mm
Y301: 16MHz; Crystal_HC49-U_Vertical

Connections:
+5V: C301.1, C303.1, C304.2, C308.1, D301.1 (K), J301.2, J303.1, L301.1, Q301.2 (E), R311.1, R318.2, U301.4 (VCC), U301.20 (AREF); also elsewhere on the board
/CANBUS/CS: U301.13 (PB1); also elsewhere on the board
/CANBUS/INT: U301.14 (PB2); also elsewhere on the board
/CANBUS/SCK: R307.2; also elsewhere on the board
/CANBUS/SI: R305.2; also elsewhere on the board
/CANBUS/SO: R306.2; also elsewhere on the board
/MCU/BUZZER: R318.1, R319.1, TP306.1, U301.12 (PB0)
/MCU/I2C_SCL: R313.1, TP305.1, U301.28 (PC5)
/MCU/I2C_SDA: R312.1, TP304.1, U301.27 (PC4)
/MCU/LED0: R314.1, U301.3 (PE0)
/MCU/LED1: R315.1, U301.6 (PE1)
/MCU/LED2: R316.1, U301.19 (PE2)
/MCU/LED3: R317.1, U301.22 (PE3)
/MCU/RESET: C307.1, D301.2 (A), R304.1, R308.1, R311.2, TP303.1, U301.29 (~RESET~/PC6)
/MCU/SPI_MISO_: R302.1, R306.1, U301.16 (PB4)
/MCU/SPI_MOSI_: R301.1, R305.1, U301.15 (PB3)
/MCU/SPI_SCK_: R303.1, R307.1, U301.17 (PB5)
/MCU/SW0: U301.10 (PD6); also elsewhere on the board
/MCU/SW1: U301.25 (PC2); also elsewhere on the board
/MCU/SW2: U301.1 (PD3); also elsewhere on the board
/MCU/SW3: U301.32 (PD2); also elsewhere on the board
/MCU/SW4: U301.23 (PC0); also elsewhere on the board
/MCU/SW5: U301.11 (PD7); also elsewhere on the board
/MCU/SW6: U301.26 (PC3); also elsewhere on the board
/MCU/SW7: U301.2 (PD4); also elsewhere on the board
/MCU/SW8: U301.24 (PC1); also elsewhere on the board
/MCU/SW9: U301.9 (PD5); also elsewhere on the board
/MCU/USART_RX: R309.2, TP302.1, U301.30 (PD0)
/MCU/USART_TX: R310.2, TP301.1, U301.31 (PD1)
GND: BZ301.2 (+), C301.2, C302.2, C303.2, C304.1, C305.2, C306.2, C307.2, C308.2, D302.1 (K), D303.1 (K), D304.1 (K), D305.1 (K), J301.1, J302.1, J303.2, R320.2, U301.5 (GND), U301.21 (GND); also elsewhere on the board
unnamed: BZ301.1 (-), D306.2 (A), Q301.3 (C), TP307.1
unnamed: C302.1, L301.2, U301.18 (AVCC)
unnamed: C305.1, U301.8 (XTAL2/PB7), Y301.1
unnamed: C306.1, U301.7 (XTAL1/PB6), Y301.2
unnamed: D302.2 (A), R314.2
unnamed: D303.2 (A), R315.2
unnamed: D304.2 (A), R316.2
unnamed: D305.2 (A), R317.2
unnamed: D306.1 (K), R320.1
unnamed: J301.3, R304.2
unnamed: J301.4, R303.2
unnamed: J301.5, R302.2
unnamed: J301.6, R301.2
unnamed: J302.2, R310.1
unnamed: J302.3, R309.1
unnamed: J302.4, R308.2
unnamed: J303.3, R313.2
unnamed: J303.4, R312.2
unnamed: Q301.1 (B), R319.2

Notes on the sheet:
Design Considerations: http://ww1.microchip.com/downloads/en/appnotes/atmel-2521-avr-hardware-design-considerations_applicationnote_avr042.pdf
ISP: https://www.cs.ou.edu/~~fagg/classes/ame3623_s05/atmel/avrisp_ug.pdf
Nota: Verificar posicionamento dos pinos do OLED e criar conector customizado para ele

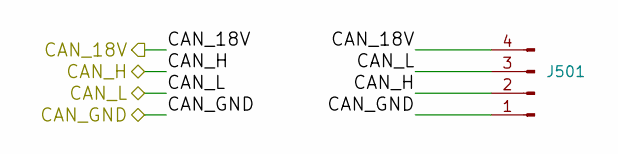
[picture p51: schematic canbus_connector.sch]

Parts:
J501: Conn_01x04_Male; PinHeader_1x04_P2.54mm_Horizontal

Connections:
/CANBUS CONN/CAN_GND: J501.1; also elsewhere on the board
/CANBUS CONN/CAN_H: J501.2; also elsewhere on the board
/CANBUS CONN/CAN_L: J501.3; also elsewhere on the board
/POWER SUPPLY/+18V_IN: J501.4; also elsewhere on the board

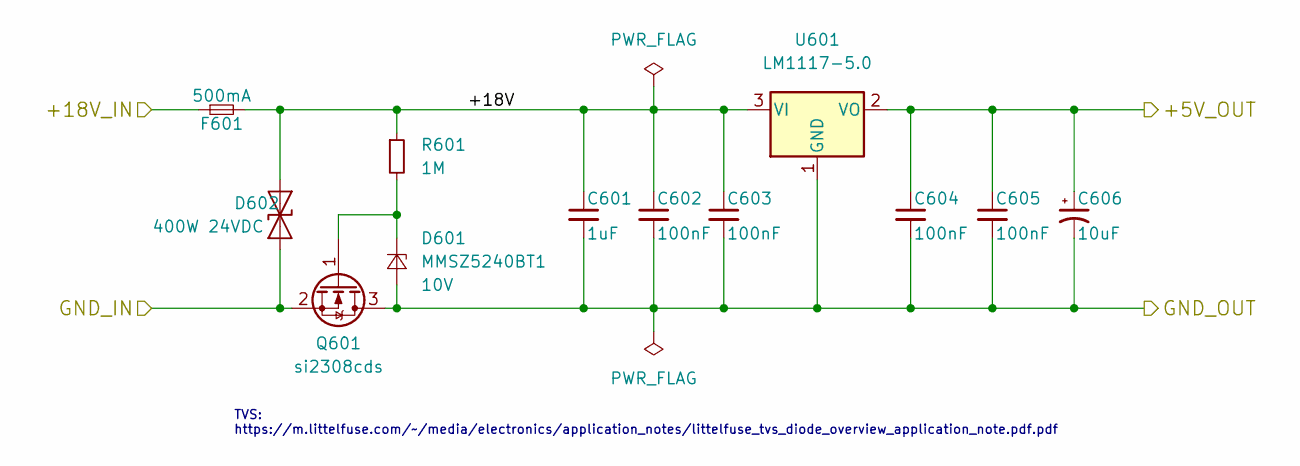
[picture p52: schematic supplies.sch]

Parts:
C601: 1uF; C_0805_2012Metric_Pad1.15x1.40mm_HandSolder
C602, C603, C604, C605: 100nF; C_0805_2012Metric_Pad1.15x1.40mm_HandSolder
C606: 10uF; CP_EIA-6032-20_AVX-F_Pad2.25x2.35mm_HandSolder
D601: MMSZ5240BT1; D_SOD-123; Voltage 10V
D602: 400W 24VDC; D_SMA
F601: 500mA; Fuse_1206_3216Metric_Pad1.42x1.75mm_HandSolder
Q601: si2308cds; SOT-23
R601: 1M; R_0805_2012Metric_Pad1.15x1.40mm_HandSolder
U601: LM1117-5.0; SOT-223-3_TabPin2

Connections:
+5V: C604.1, C605.1, C606.1, U601.2 (VO); also elsewhere on the board
/CANBUS CONN/CAN_GND: D602.2 (A2), Q601.2 (S); also elsewhere on the board
/POWER SUPPLY/+18V: C601.1, C602.1, C603.1, D602.1 (A1), F601.2, R601.1, U601.3 (VI)
/POWER SUPPLY/+18V_IN: F601.1; also elsewhere on the board
GND: C601.2, C602.2, C603.2, C604.2, C605.2, C606.2, D601.2 (A), Q601.3 (D), U601.1 (GND); also elsewhere on the board
unnamed: D601.1 (K), Q601.1 (G), R601.2

Notes on the sheet:
TVS: https://m.littelfuse.com/~~/media/electronics/application_notes/littelfuse_tvs_diode_overview_application_note.pdf.pdf

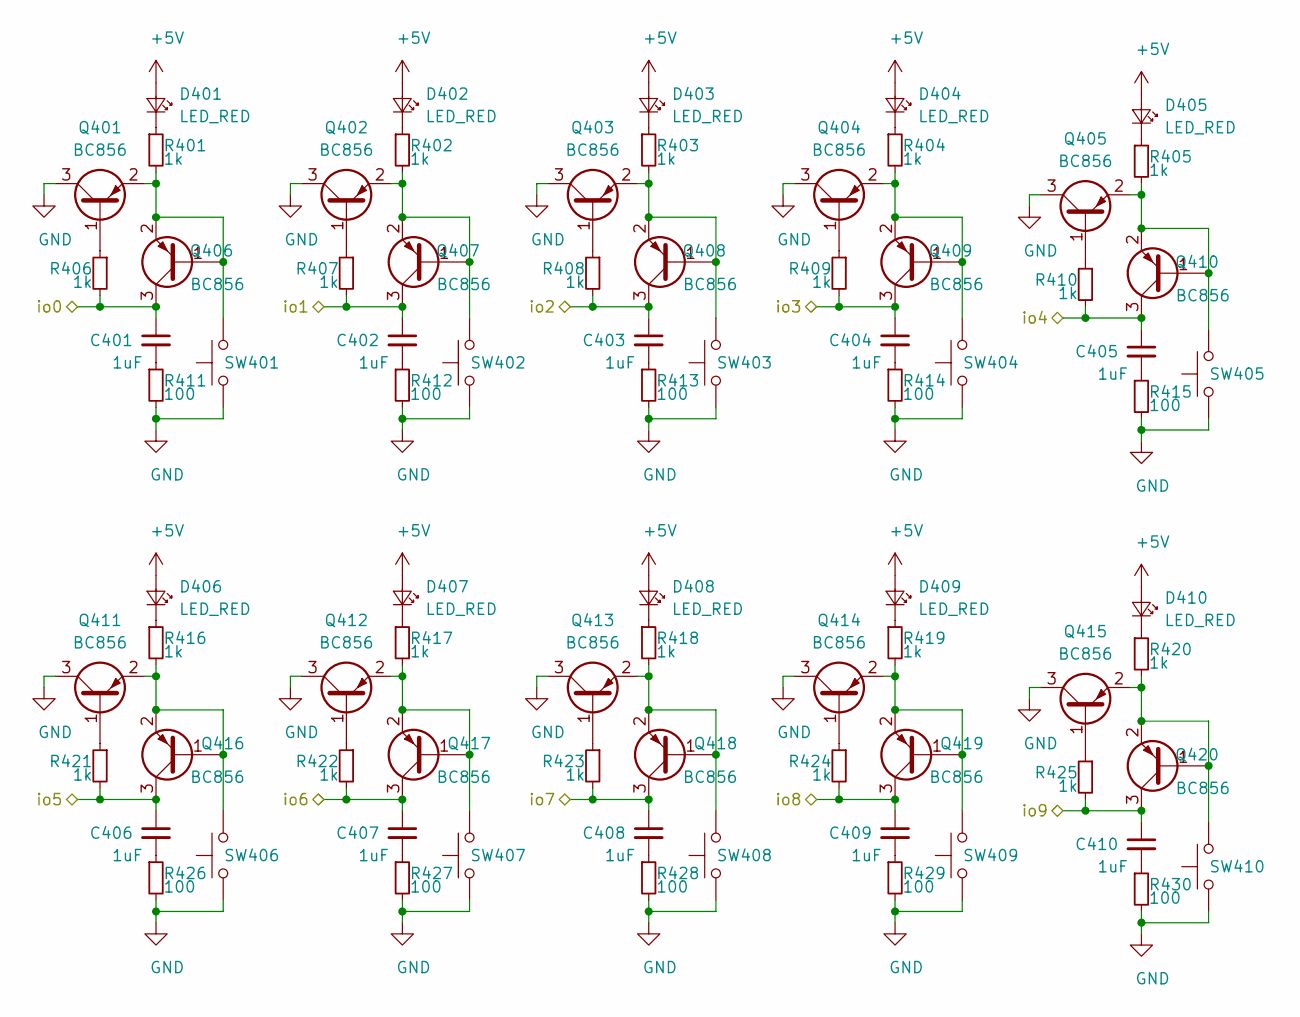
[picture p53: schematic switches.sch]

Parts:
C401, C402, C403, C404, C405, C406, C407, C408, C409, C410: 1uF; C_0805_2012Metric_Pad1.15x1.40mm_HandSolder
D401, D402, D403, D404, D405, D406, D407, D408, D409, D410: LED_RED; LED_0805_2012Metric_Pad1.15x1.40mm_HandSolder
Q401, Q402, Q403, Q404, Q405, Q406, Q407, Q408, Q409, Q410, Q411, Q412, Q413, Q414, Q415, Q416, Q417, Q418, Q419, Q420: BC856; SOT-23
R401, R402, R403, R404, R405, R406, R407, R408, R409, R410, R416, R417, R418, R419, R420, R421, R422, R423, R424, R425: 1k; R_0805_2012Metric_Pad1.15x1.40mm_HandSolder
R411, R412, R413, R414, R415, R426, R427, R428, R429, R430: 100; R_0805_2012Metric_Pad1.15x1.40mm_HandSolder
SW401, SW402, SW403, SW404, SW405, SW406, SW407, SW408, SW409, SW410: SW_Push; SW_PUSH-12mm

Connections:
+5V: D401.2 (A), D402.2 (A), D403.2 (A), D404.2 (A), D405.2 (A), D406.2 (A), D407.2 (A), D408.2 (A), D409.2 (A), D410.2 (A); also elsewhere on the board
/MCU/SW0: C401.1, Q406.3 (C), R406.2; also elsewhere on the board
/MCU/SW1: C402.1, Q407.3 (C), R407.2; also elsewhere on the board
/MCU/SW2: C403.1, Q408.3 (C), R408.2; also elsewhere on the board
/MCU/SW3: C404.1, Q409.3 (C), R409.2; also elsewhere on the board
/MCU/SW4: C405.1, Q410.3 (C), R410.2; also elsewhere on the board
/MCU/SW5: C406.1, Q416.3 (C), R421.2; also elsewhere on the board
/MCU/SW6: C407.1, Q417.3 (C), R422.2; also elsewhere on the board
/MCU/SW7: C408.1, Q418.3 (C), R423.2; also elsewhere on the board
/MCU/SW8: C409.1, Q419.3 (C), R424.2; also elsewhere on the board
/MCU/SW9: C410.1, Q420.3 (C), R425.2; also elsewhere on the board
GND: Q401.3 (C), Q402.3 (C), Q403.3 (C), Q404.3 (C), Q405.3 (C), Q411.3 (C), Q412.3 (C), Q413.3 (C), Q414.3 (C), Q415.3 (C), R411.2, R412.2, R413.2, R414.2, R415.2, R426.2, R427.2, R428.2, R429.2, R430.2, SW401.1, SW402.1, SW403.1, SW404.1, SW405.1, SW406.1, SW407.1, SW408.1, SW409.1, SW410.1; also elsewhere on the board
unnamed: C401.2, R411.1
unnamed: C402.2, R412.1
unnamed: C403.2, R413.1
unnamed: C404.2, R414.1
unnamed: C405.2, R415.1
unnamed: C406.2, R426.1
unnamed: C407.2, R427.1
unnamed: C408.2, R428.1
unnamed: C409.2, R429.1
unnamed: C410.2, R430.1
unnamed: D401.1 (K), R401.1
unnamed: D402.1 (K), R402.1
unnamed: D403.1 (K), R403.1
unnamed: D404.1 (K), R404.1
unnamed: D405.1 (K), R405.1
unnamed: D406.1 (K), R416.1
unnamed: D407.1 (K), R417.1
unnamed: D408.1 (K), R418.1
unnamed: D409.1 (K), R419.1
unnamed: D410.1 (K), R420.1
unnamed: Q401.1 (B), R406.1
unnamed: Q401.2 (E), Q406.1 (B), Q406.2 (E), R401.2, SW401.2
unnamed: Q402.1 (B), R407.1
unnamed: Q402.2 (E), Q407.1 (B), Q407.2 (E), R402.2, SW402.2
unnamed: Q403.1 (B), R408.1
unnamed: Q403.2 (E), Q408.1 (B), Q408.2 (E), R403.2, SW403.2
unnamed: Q404.1 (B), R409.1
unnamed: Q404.2 (E), Q409.1 (B), Q409.2 (E), R404.2, SW404.2
unnamed: Q405.1 (B), R410.1
unnamed: Q405.2 (E), Q410.1 (B), Q410.2 (E), R405.2, SW405.2
unnamed: Q411.1 (B), R421.1
unnamed: Q411.2 (E), Q416.1 (B), Q416.2 (E), R416.2, SW406.2
unnamed: Q412.1 (B), R422.1
unnamed: Q412.2 (E), Q417.1 (B), Q417.2 (E), R417.2, SW407.2
unnamed: Q413.1 (B), R423.1
unnamed: Q413.2 (E), Q418.1 (B), Q418.2 (E), R418.2, SW408.2
unnamed: Q414.1 (B), R424.1
unnamed: Q414.2 (E), Q419.1 (B), Q419.2 (E), R419.2, SW409.2
unnamed: Q415.1 (B), R425.1
unnamed: Q415.2 (E), Q420.1 (B), Q420.2 (E), R420.2, SW410.2

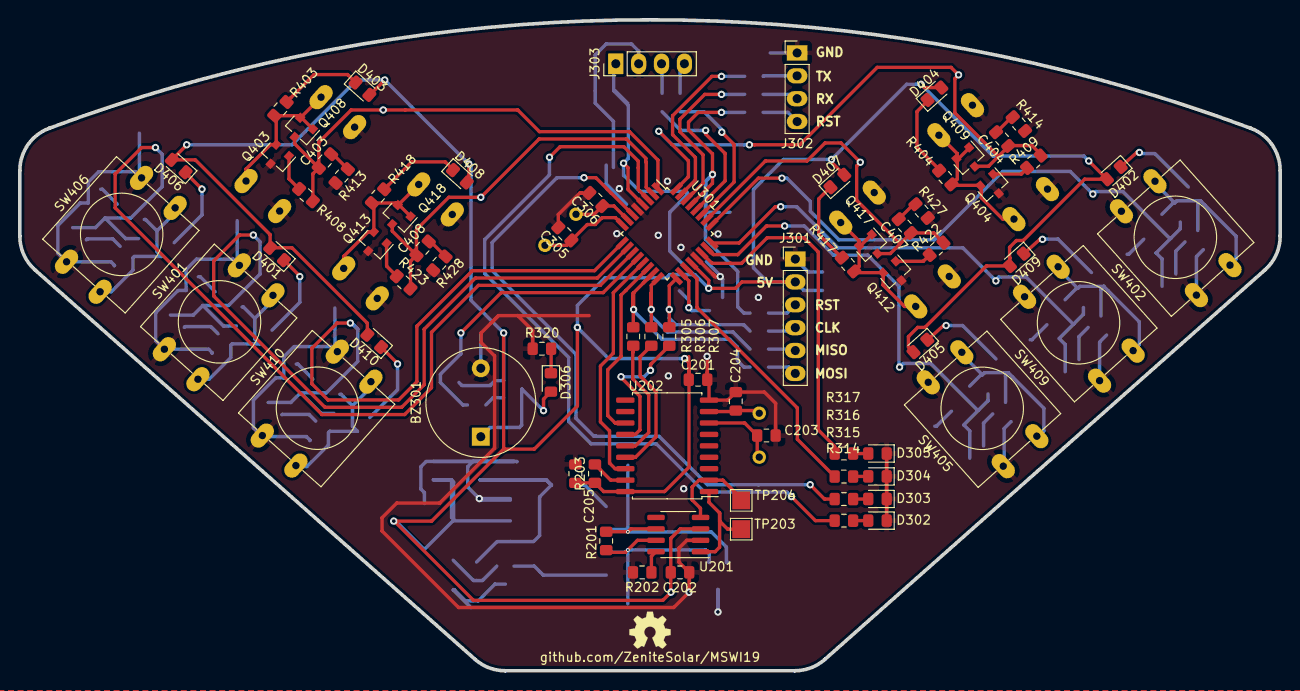
[picture p54: board mswi.kicad_pcb from above]

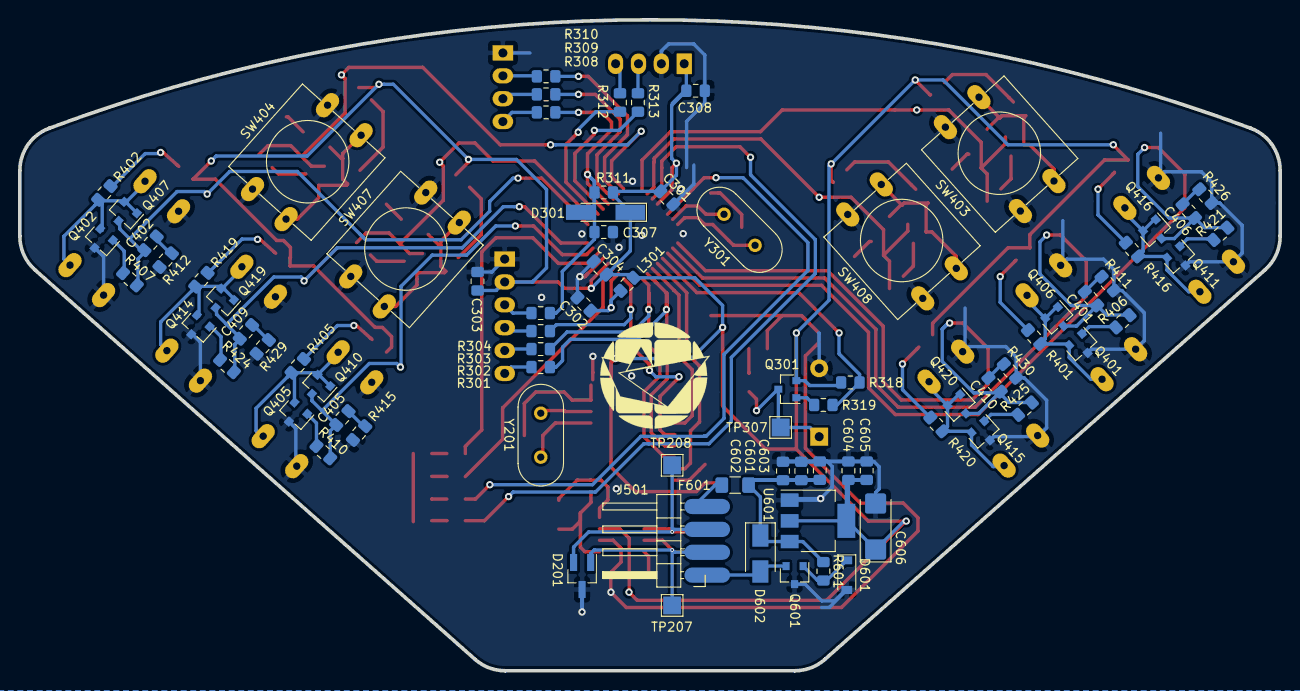
[picture p55: board mswi.kicad_pcb from below]

Board: 2 copper layers, 140.0 x 72.3 mm, 152 parts (80 on the bottom side), 101 nets.
