ZeniteSolar/MSWI19/firmware/src/main.c

// coding: utf-8

#include "main.h"

void init(void)
{
    #ifdef SPI_ON
        //spi slave-select as output to atmega work as the spi master
       // set_bit(DDRB, PB1);
        set_bit(DDRB, PB2);     
        set_bit(DDRE, PE2);

    #endif

    #ifdef USART_ON
        usart_init(MYUBRR,0,1);                         // inicializa a usart
        VERBOSE_MSG_INIT(usart_send_string("\n\n\nUSART... OK!\n\r"));
    #endif

    #ifdef IO_ON
        leds_init();
        switches_init();
        buzzer_init();
        VERBOSE_MSG_INIT(usart_send_string("IOs... OK!\n\r"));
    #else
        VERBOSE_MSG_INIT(usart_send_string("IOs... OFF!\n\r"));
    #endif
    
    #ifdef UI_ON
        VERBOSE_MSG_INIT(usart_send_string("UI..."));
        ui_init();
        VERBOSE_MSG_INIT(usart_send_string(" OK!\n\r"));
    #else
        VERBOSE_MSG_INIT(usart_send_string("UI... OFF!\n\r"));
    #endif

    #ifdef WATCHDOG_ON
        VERBOSE_MSG_INIT(usart_send_string("WATCHDOG..."));
        wdt_init();
        VERBOSE_MSG_INIT(usart_send_string(" OK!\n\r"));
        wdt_reset();
    #else
        VERBOSE_MSG_INIT(usart_send_string("WATCHDOG... OFF!\n\r"));
    #endif

    #ifdef WATCHDOG_ON
        wdt_reset();
    #endif

    #ifdef CAN_ON
        VERBOSE_MSG_INIT(usart_send_string("CAN (500kbps)..."));
        can_init(BITRATE_500_KBPS);
        //can_set_mode(LOOPBACK_MODE);
        VERBOSE_MSG_INIT(usart_send_string(" OK!\n\r"));
        VERBOSE_MSG_INIT(usart_send_string("CAN filters..."));
        can_static_filter(can_filter);
        VERBOSE_MSG_INIT(usart_send_string(" OK!\n\r"));
    #else
        VERBOSE_MSG_INIT(usart_send_string("CAN... OFF!\n\r"));
    #endif

    #ifdef WATCHDOG_ON
        wdt_reset();
    #endif

    #ifdef ADC_ON
        VERBOSE_MSG_INIT(usart_send_string("ADC..."));
        adc_init();
        VERBOSE_MSG_INIT(usart_send_string(" OK!\n\r"));
    #else
        VERBOSE_MSG_INIT(usart_send_string("ADC... OFF!\n\r"));
    #endif

    #ifdef WATCHDOG_ON
        wdt_reset();
    #endif

    #ifdef SLEEP_ON
        VERBOSE_MSG_INIT(usart_send_string("SLEEP..."));
        sleep_init();
        VERBOSE_MSG_INIT(usart_send_string(" OK!\n\r"));
    #else
        VERBOSE_MSG_INIT(usart_send_string("SLEEP... OFF!\n\r"));
    #endif

    #ifdef WATCHDOG_ON
        wdt_reset();
    #endif

    #ifdef CHRONOMETER_ON
        chronometer_init();
    #endif

    #ifdef CONTROLLER_ON
        controller_init();
    #endif

 	#ifdef MACHINE_ON
        VERBOSE_MSG_INIT(usart_send_string("MACHINE..."));
		machine_init();
        VERBOSE_MSG_INIT(usart_send_string(" OK!\n\r"));
    #else
        VERBOSE_MSG_INIT(usart_send_string("MACHINE... OFF!\n\r"));
	#endif

    #ifdef WATCHDOG_ON
        wdt_reset();
    #endif

    #ifdef MACHINE_ON
        print_configurations();
    #endif

    #ifdef WATCHDOG_ON
        wdt_reset();
    #endif

    sei();
    
}

int main(void)
{
    init();

    for(;;){
        #ifdef WATCHDOG_ON
            wdt_reset();
	    #endif

        #ifdef MACHINE_ON
            machine_run();
        #endif

	    #ifdef SLEEP_ON
            sleep_mode();
       	#endif
	  }
}


/**
 * @brief se em debug, fica chaveando os pinos de debugs até o reset do watchdog
 */
ISR(BADISR_vect)
{
    for(;;){
        VERBOSE_MSG_ERROR(usart_send_string("\nFATAL ERROR: BAD ISR."));
        #ifdef WATCHDOG_ON
            VERBOSE_MSG_ERROR(usart_send_string("WAITING FOR WATCHDOG TO RESET...\n\r"));
        #endif
        #ifdef DEBUG_ON
            DEBUG0;
            DEBUG1;
            _delay_ms(100);
        #endif
    }
}
