ZeniteSolar/MSWI19/firmware/src/input.c

#include "input.h"

static void (*callback_functions[10])(void *);
static void (*callback_arguments[10]);
static void callback_caller(input_names_t input);
static const uint8_t input_cooldown_time = 2;
static const uint8_t input_cooldown_time_first = 12;
static inline void input_update_sw0(void);
static inline void input_update_sw1(void);
static inline void input_update_sw2(void);
static inline void input_update_sw3(void);
static inline void input_update_sw4(void);
static inline void input_update_sw5(void);
static inline void input_update_sw6(void);
static inline void input_update_sw7(void);
static inline void input_update_sw8(void);
static inline void input_update_sw9(void);
static switches_t switches_old;

void input_assign_callback(input_names_t input, void *function, void *argument)
{
    if(input < input_length) if(function){
        callback_functions[input] = function;
        callback_arguments[input] = argument;
    }
}

static void callback_caller(input_names_t input)
{
    if(input < input_length){
        if(callback_functions[input]){
            callback_functions[input](callback_arguments[input]);
            #ifdef BUZZER_ON
            buzzer_beep(buzzer_beep0);
            #endif
        }
    }
}

void inputs_update(void)
{
    switches_read();

    input_update_sw0();
    input_update_sw1();
    input_update_sw2();
    input_update_sw3();
    input_update_sw4();
    input_update_sw5();
    input_update_sw6();
    input_update_sw7();
    input_update_sw8();
    input_update_sw9();

    switches_old.all = switches.all;
}

static inline void input_update_sw0(void)
{
    static uint8_t input_cooldown = 0;
    if(input_cooldown) input_cooldown--;
    else{
        if(switches.sw0 == switch_pressed){
            VERBOSE_MSG_INPUT(usart_send_string("\r[sw0 pressed]"));
            callback_caller(sw0);
            if(switches.sw0 == switches_old.sw0){
                input_cooldown = input_cooldown_time;
            }else{
                input_cooldown = input_cooldown_time_first;
            }
        }
    }
    if(switches.sw0 == switch_released){
        if(switches_old.sw0 == switch_pressed){
            VERBOSE_MSG_INPUT(usart_send_string("\r[sw0 released]"));
            input_cooldown = 0;
        }
    } 
}

static inline void input_update_sw1(void)
{
    static uint8_t input_cooldown = 0;
    if(input_cooldown) input_cooldown--;
    else{
        if(switches.sw1 == switch_pressed){
            VERBOSE_MSG_INPUT(usart_send_string("\r[sw1 pressed]"));
            callback_caller(sw1);
            if(switches.sw1 == switches_old.sw1){
                input_cooldown = input_cooldown_time;
            }else{
                input_cooldown = input_cooldown_time_first;
            }
        }
    }
    if(switches.sw1 == switch_released){
        if(switches_old.sw1 == switch_pressed){
            VERBOSE_MSG_INPUT(usart_send_string("\r[sw1 released]"));
            input_cooldown = 0;
        }
    } 
}

static inline void input_update_sw2(void)
{
    static uint8_t input_cooldown = 0;
    if(input_cooldown) input_cooldown--;
    else{
        if(switches.sw2 == switch_pressed){
            VERBOSE_MSG_INPUT(usart_send_string("\r[sw2 pressed]"));
            callback_caller(sw2);
            if(switches.sw2 == switches_old.sw2){
                input_cooldown = input_cooldown_time;
            }else{
                input_cooldown = input_cooldown_time_first;
            }
        }
    }
    if(switches.sw2 == switch_released){
        if(switches_old.sw2 == switch_pressed){
            VERBOSE_MSG_INPUT(usart_send_string("\r[sw2 released]"));
            input_cooldown = 0;
        }
    } 
}

static inline void input_update_sw3(void)
{
    static uint8_t input_cooldown = 0;
    if(input_cooldown) input_cooldown--;
    else{
        if(switches.sw3 == switch_pressed){
            VERBOSE_MSG_INPUT(usart_send_string("\r[sw3 pressed]"));
            callback_caller(sw3);
            if(switches.sw3 == switches_old.sw3){
                input_cooldown = input_cooldown_time;
            }else{
                input_cooldown = input_cooldown_time_first;
            }
        }
    }
    if(switches.sw3 == switch_released){
        if(switches_old.sw3 == switch_pressed){
            VERBOSE_MSG_INPUT(usart_send_string("\r[sw3 released]"));
            input_cooldown = 0;
        }
    } 
}

static inline void input_update_sw4(void)
{
    static uint8_t input_cooldown = 0;
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
            }
        }
    }
    if(switches.sw9 == switch_released){
        if(switches_old.sw9 == switch_pressed){
            VERBOSE_MSG_INPUT(usart_send_string("\r[sw9 released]"));
            input_cooldown = 0;
        }
    } 
}
