ZeniteSolar/MSWI19/(commit log)

2019-08-30 initial design
    [placa_joaoa_timao.DXF, timao_joao_2_3.DXF]
2019-08-30 initial design loaded into kicad
    [mswi.kicad_pcb, mswi.sch]
2019-09-04 Oportunidades, prospecção, levantamento de dados
2019-10-10 ignoring unneeded kicad files
2019-10-10 Full schematic added. (To be revised).
    [analog.sch, atmega328p.sch, canbus.sch, canbus_connector.sch, main.sch, mswi.kicad_pcb, mswi.sch, supplies.sch]
2019-10-11 switches reworked, buzzer added
    [atmega328p.sch, canbus.sch, canbus_connector.sch, main.sch, supplies.sch, switches.sch]
2019-10-11 Schematics Annotated
    [atmega328p.sch, canbus.sch, canbus_connector.sch, main.sch, supplies.sch, switches.sch]
2019-10-11 Footprints associated
    [atmega328p.sch, supplies.sch, switches.sch]
2019-10-11 Test points added. Buzz footprint added
    [atmega328p.sch]
2019-10-11 Schematic PDF added
2019-10-11 renamed to avoid problems with KiCAD
    [mswi.kicad_pcb, mswi.sch]
2019-10-11 components imported
    [mswi.kicad_pcb]
2019-10-11 TODO list added
    [mswi.kicad_pcb]
2019-10-11 TODO list updated
    [mswi.kicad_pcb]
2019-10-11 PCB geometry added
    [mswi.kicad_pcb]
2019-10-11 ISP connector changed to vertical
    [mswi.kicad_pcb]
2019-10-11 Switch&led interface first iteration
    [mswi.kicad_pcb]
2019-10-11 Buzzer interface first iteration
    [mswi.kicad_pcb]
2019-10-11 all swiches&leds interface routed
    [mswi.kicad_pcb]
2019-10-11 TVS added
    [supplies.sch]
2019-10-11 input and power supply routed
    [mswi.kicad_pcb]
2019-10-11 CANBUS connector changed
    [canbus_connector.sch]
2019-10-11 CANBUS connector changed, footprint added
    [canbus_connector.sch]
2019-10-11 pwr sup. rounted with new can connector
    [mswi.kicad_pcb]
2019-10-11 screws removed
    [mswi.sch]
2019-10-11 routing: wip
    [atmega328p.sch, mswi.kicad_pcb]
2019-10-16 Routing done. Needs rework to fabrication
    [atmega328p.sch, mswi.kicad_pcb, supplies.sch]
2019-10-16 Rules adapted to the manufactoring method (CNC)
    [mswi.kicad_pcb]
2019-10-16 SW 3D added
    [mswi.kicad_pcb]
2019-10-16 Silkscreen organized
    [mswi.kicad_pcb]
2019-10-16 Fab annotations done
    [mswi.kicad_pcb]
2019-10-16 leds changed to front
    [mswi.kicad_pcb]
2019-10-16 buzzer and switch 3D enhanced
    [buzzer.step, mswi.kicad_pcb, switch.FCStd, switch.step]
2019-10-22 Done. Adjusted for standart industrial capability
    [mswi-B_Adhes.gbr, mswi-B_CrtYd.gbr, mswi-B_Cu.gbr, mswi-B_Fab.gbr, mswi-B_Mask.gbr, mswi-B_Paste.gbr, mswi-B_SilkS.gbr, mswi-Cmts_User.gbr]
2019-10-22 Simple alternative for input power supply
2019-10-22 Models ok
    [switch.step]
2019-10-22 3D mdoels updated
    [display.step, mswi.kicad_pcb]
2019-10-24 CAN H and L wasnt properly connected
    [mswi-B_Adhes.gbr, mswi-B_CrtYd.gbr, mswi-B_Cu.gbr, mswi-B_Fab.gbr, mswi-B_Mask.gbr, mswi-B_Paste.gbr, mswi-B_SilkS.gbr, mswi-Cmts_User.gbr]
2019-11-06 pequenos ajustes para produção
    [mswi-B_Adhes.gbr, mswi-B_CrtYd.gbr, mswi-B_Cu.gbr, mswi-B_Fab.gbr, mswi-B_Mask.gbr, mswi-B_Paste.gbr, mswi-B_SilkS.gbr, mswi-Cmts_User.gbr]
2019-11-28 Working hello world with display.
    - Makefiles updated to compile for atmega328pb.
    - Firmware was cleaned,
    - Working display with a "Hello World!" message.
    - Usart working
    - Leds addressed but not tested yet!
    - CAN not working yet!
    [adc.c, adc.h, can_app.c, can_filters.h, conf.h, dbg_vrb.h, display.c, machine.c]
2019-11-28 CAN initialized. Need to be tested with others CAN devices.
2019-12-08 initial 3D design to be printed
    [CON_TIMAO_BARCO.STL, costa_tampa.STL, timao_joao_V_2.STL]
2019-12-08 calling unknown callback fixed
    [input.c]
2019-12-09 i2c frequency upgraded to 800kHz
2019-12-14 prescaler adjusted to minimize errors
    [conf.h]
2019-12-15 power controller implemented
2020-01-18 teste de comunicação com o MAM
2020-01-25 using software spi
2022-05-09 fix multiple definition for new versions of gcc
    [can_app.c, can_app.h, chronometer.c, chronometer.h, io.c, io.h, machine.c, machine.h]
2022-06-27 Add BOM
    [mswi.csv]
